mikermak/StereoBoy_Firmware/retroid/artwork/kleur_cartridge_boven_50.98x60.68mm_1200dpi.png

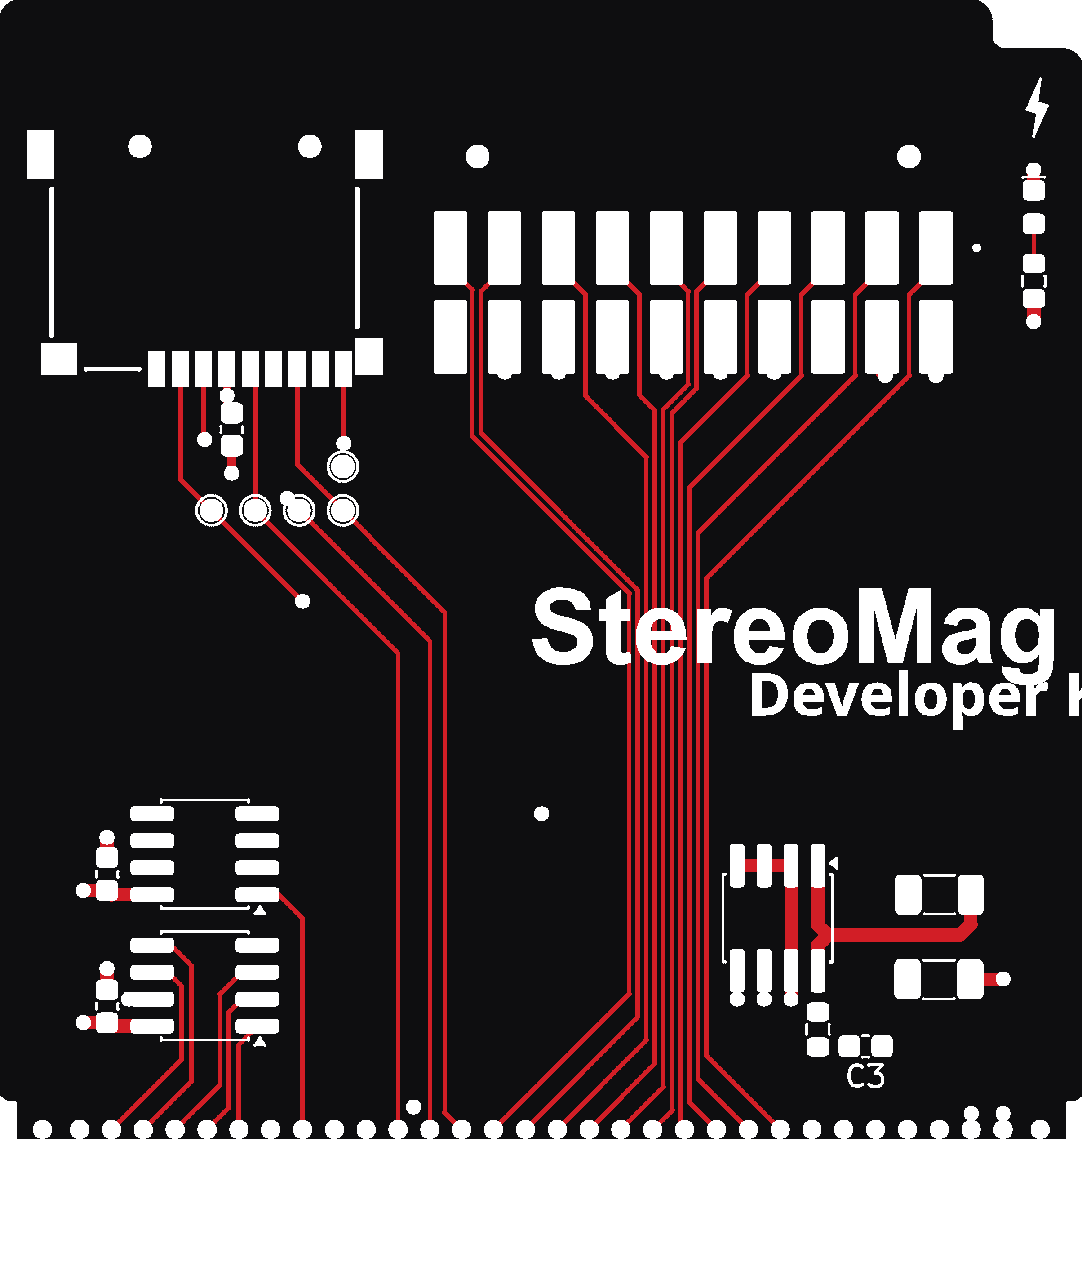
retroid/artwork/kleur_cartridge_boven_50.98x60.68mm_1200dpi.png
