mikermak/StereoBoy_Firmware/retroid/artwork/kleur_hoofdprint_onder_69.67x116.69mm_1200dpi.png

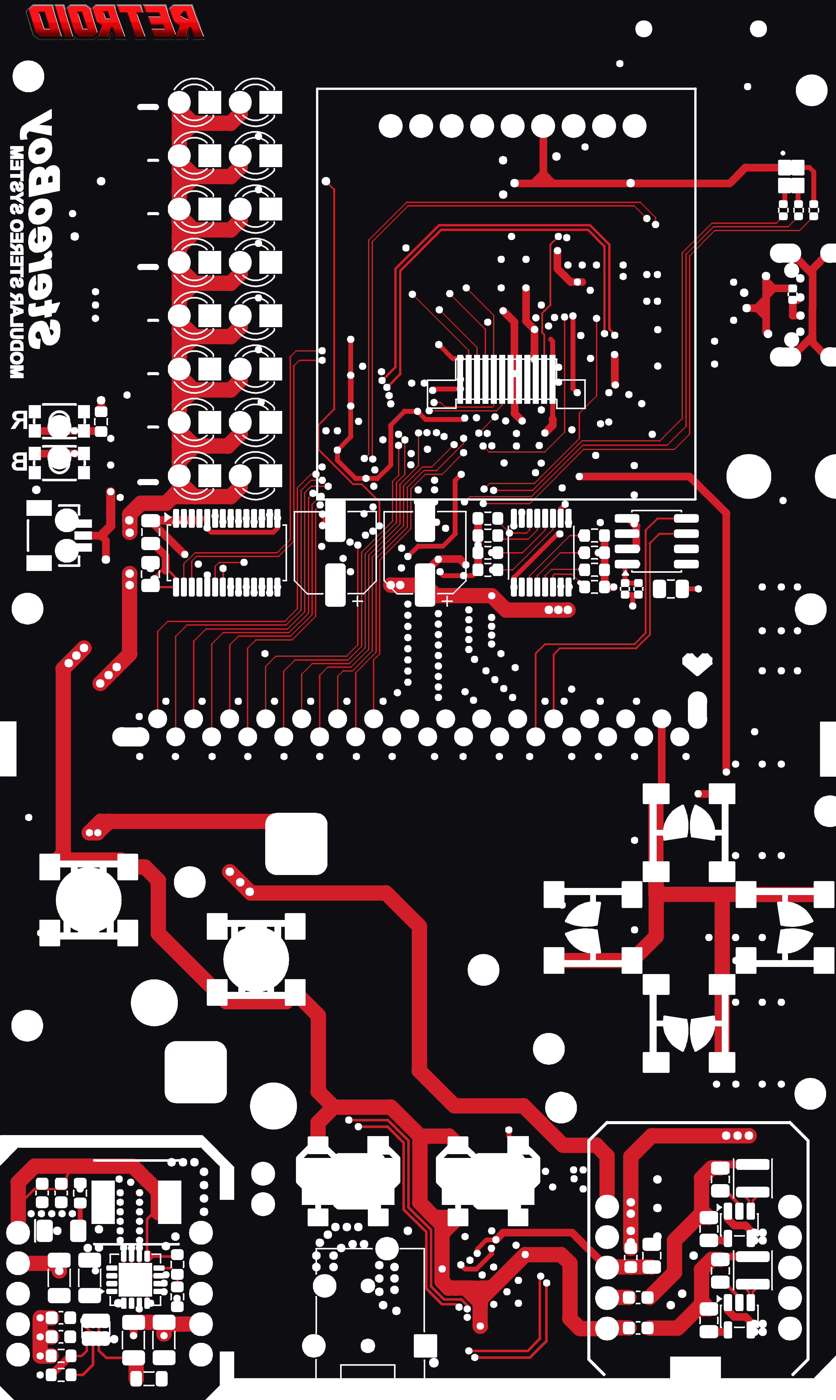
retroid/artwork/kleur_hoofdprint_onder_69.67x116.69mm_1200dpi.png
