mikermak/StereoBoy_Firmware/retroid/artwork/voorbeeld_cartridge_boven.png

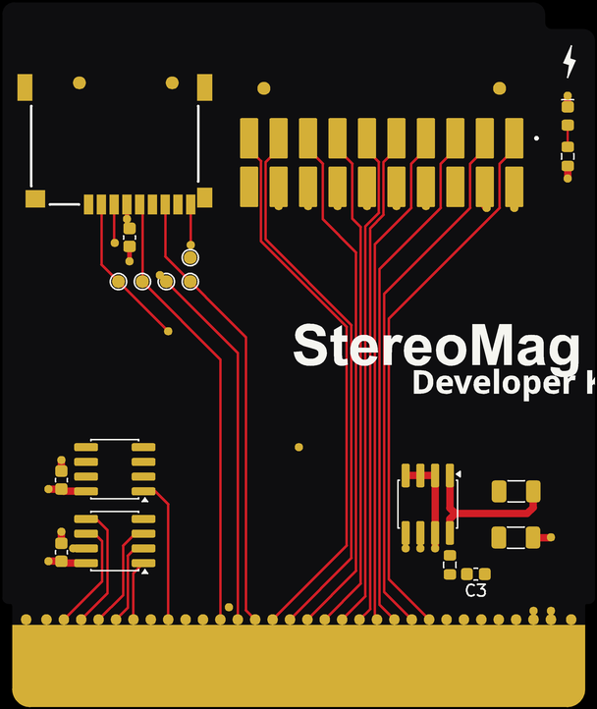
retroid/artwork/voorbeeld_cartridge_boven.png
