mikermak/StereoBoy_Firmware/retroid/productie/cartridge/JLCPCB_BOM.csv

Comment | Designator | Footprint | LCSC Part #
W25Q16JVSNIQ | U1 | SOIC-8_3.9x4.9mm_P1.27mm | C115407
TF-01A microSD push-push | J6 | microSD_External_Pin | C20613191
100nF 1206 | C1,C2 | C_1206_3216Metric | C24497
100nF 0603 | C6,C7,C8 | C_0603_1608Metric
10uF 0603 | C3 | C_0603_1608Metric
470R 0603 | R1 | R_0603_1608Metric | C23179
110k 0603 | R2 | R_0603_1608Metric
Green LED 0603 | D1 | LED_0603_1608Metric_Green
