mikermak/StereoBoy_Firmware/retroid/StereoBoy_bestellijst.xlsx

Sheet: Overzicht
StereoBoy - haalbaarheid en bestelplan
Gebaseerd op github.com/iamericmin/StereoBoy_Firmware (commit a4c152c, 30-9-2026) + StereoMag-cartridge van hackaday.io/project/205771
Onderdeel | Status | Wat betekent dat voor jou
Hoofdprint (KiCad) | Compleet | Schema + printontwerp staan in de repo. De ontwerper meldt dat R1 volledig werkt. 4 lagen, 1,0 mm dik, ca. 70 x 117 mm, onderdelen aan BEIDE kanten. Open het in KiCad 10 (ouder lukt niet).
Gerbers in de repo | Opgelost | De zip in de repo is van 9-3-2026. Nieuwe gerbers, boorbestanden en posities zijn met KiCad 10.0.6 gemaakt: zie productie/.
PSU-module | Op dezelfde print | Linksonder zit een los af te breken voedingsmoduletje (boost, power-mux). R1 = AAA-batterijen. De ontwerper werkt aan R2 met een LiPo - die is nog niet gepubliceerd.
Cartridge (StereoMag) | Apart te downloaden | Staat NIET in de GitHub-repo, wel op Hackaday (stereoMag.kicad_*). Op de cartridge zitten de flashchip (de firmware!) en het microSD-slot. Zonder cartridge start het apparaat niet.
Firmware | Compileert | Door mij getest: bouwt zonder fouten met Pico SDK 2.3.0 (180 KB flash, 205 KB RAM). Past ruim in de 2 MB-flash.
Firmware <-> cartridge | Opgelost (ongetest) | De firmware gebruikte SDIO; de cartridge is via SPI aangesloten. Aangepast in hw_config.c: firmware/StereoBoy_FW_sd-spi.uf2 + patch. Compileert, maar is nog niet op echte hardware getest.
Muziekbibliotheek-script | Ontbreekt | De firmware heeft .artists.sbc / .albums.sbc / .tracks.sbc (+ artwork.lut/bin) op de SD-kaart nodig. Het Python-script dat die maakt staat niet in de repo. Het formaat is gewoon een dump van C-structs, dus na te bouwen.
Behuizing | Game Boy Pocket | Past in een (aftermarket) GB Pocket-behuizing. STL's voor een 3D-geprinte batterij-achterkant + klepje staan in KiCad_files/stereoBoy_3D (te printen op je Bambu A1).
Conclusie |  | Haalbaar, maar geen beginnersbouwpakket. Laat de hoofdprint bij JLCPCB monteren (QFN-80 met 0,4 mm pitch en 0402-onderdelen aan twee kanten). De cartridge (SOIC/0603) en de THT-onderdelen kun je zelf solderen. Reken op 2 software-klusjes: SD-kaart via SPI, en een script voor de bibliotheek.
Aanpak in stappen
1 |  | KLAAR: KiCad 10 geinstalleerd, DRC gedraaid en de productiebestanden staan in de map productie/.
2 |  | Bestel bij JLCPCB: 4 lagen, 1,0 mm, ENIG. Montage aan beide kanten. Upload productie/hoofdprint/gerbers_hoofdprint.zip, JLCPCB_BOM.csv en JLCPCB_CPL.csv. Controleer in de preview de draaiing van elk IC (zie productie/BESTELLEN.md).
3 |  | Onderdelen die JLC niet heeft (VS1053B-L, spoelen L1/L4/L5/L9, RGB-LED, enz.) bestel je bij Digikey/Mouser: laat ze door JLC monteren (eigen onderdelen opsturen of global sourcing) of soldeer ze zelf.
4 |  | Bestel de cartridgeprint (2 lagen, 1,0 mm, ENIG voor de goudcontacten) en soldeer hem zelf - zie tabblad Cartridge.
5 |  | Bestel de losse onderdelen en de behuizing (tabblad Behuizing & los). Print de batterij-achterkant.
6 |  | Firmware: houd SW2 (BOOTSEL) ingedrukt, druk op SW1 (reset), en sleep het .uf2-bestand naar de USB-schijf. De cartridge moet erin zitten (daar zit de flash).
7 |  | Zet MP3's op een FAT32-microSD en genereer de .sbc-cachebestanden (script nog te schrijven).
Kostenschatting (EUR, eerste exemplaar) |  | Printprijs en onderdelen gecheckt op 1-10-2026 (zie tabblad Prijzen). De montage is een schatting.
Hoofdprint 5 st. (4 lagen, 1,0 mm, ENIG, zwart) | ca. 52 | Gecheckt: $55,60.
Verzending JLCPCB (DHL, inclusief invoerkosten) | ca. 29 | Gecheckt: $30,86.
Montage 2 st. aan beide kanten, incl. onderdelen | 140 - 205 | Schatting. VS1053B alleen is al $16,50 per stuk.
Digikey (L1, L4/L5, volumewiel) + verzending | 5 - 25 | Onder EUR 50 betaal je verzendkosten; je kunt JLC ze ook laten inkopen.
Cartridgeprint + onderdelen | 15 - 30 | Kan in dezelfde JLC-bestelling (scheelt verzending).
Behuizing, scherm en losse onderdelen | 30 - 50 | Gecheckt: scherm ca. EUR 3, GBP-shell EUR 11-14.
Totaal (indicatie) | 270 - 390 | Je hebt daarna onderdelen voor een tweede exemplaar.

Sheet: Prijzen
Gecheckte prijzen en voorraad (1-10-2026)
Opgezocht in de browser op jlcpcb.com, lcsc.com, digikey.nl en aliexpress.com. Er is niets besteld.
Wat | Waar / LCSC # | Voorraad | Prijs | Opmerking
PCB hoofdprint, 5 st. | JLCPCB | 4 lagen, 70x117 mm, 1,0 mm, zwart, ENIG, via 0,2 mm | $55,60 | Opbouw: board $5,10 + engineering $25 + ENIG $17,50 + zwart $8. Groen scheelt $8; HASL i.p.v. ENIG scheelt $17,50.
Verzending DHL Express | JLCPCB | DDP (invoerkosten inbegrepen), 2-4 werkdagen | $30,86 | Geschat door JLC op basis van gewicht.
RP2350B | JLCPCB C42415655 | Op voorraad: 3.875 | $1,28 | LCSC zelf: niet leverbaar; via JLC-montage wel.
VS1053B-L | JLCPCB C9922 | Pre-order, ca. 11 dagen | $16,51 | Duurste onderdeel. LCSC: 0 op voorraad.
TLV320DAC3100IRHBR | JLCPCB C179677 | Op voorraad: 2.171 | $1,87
TPS61090RSAR | JLCPCB C206167 | Op voorraad: 2.436 | $2,20
PCA9685PW,118 | JLCPCB C2678753 | Op voorraad: 430 | $2,87 | Alternatief C92206 ($3,64, 1.209 st.).
SN74HC165PWR | LCSC C43420 | Op voorraad: 31.435 | $0,23
APX803S-31SA-7 | LCSC C129757 | Op voorraad: 2.968 | $0,39
AOTA-B201610S3R3-101-T (L9) | LCSC C42411119 | Op voorraad: 3.675 | $0,29
PKMCS0909E4000-R1 (zoemer) | JLCPCB C910763 | Op voorraad: 1.483 | $1,10
BAT60JFILM (D22) | JLCPCB C5377811 | Op voorraad: 4 | $0,06 | Weinig voorraad. Gelijkwaardig: BAT60B C3018529 (47.342 st.).
CLMVC RGB-LED (D17) | JLCPCB C5187905 | Pre-order, min. 56 st., ca. 25 dagen | $8,69 | Overweeg een vervanger met dezelfde footprint (2x2 mm, common anode).
AMELA3012S-2R2MT (L4, L5) | Digikey 535-AMELA3012S-2R2MTCT-ND | Op voorraad: 827 | EUR 0,84 /st. | Niet bij LCSC/JLC.
AMPLH7020S-6R8MT (L1) | Digikey | Op voorraad: 2.001 | EUR 0,73 | Niet bij LCSC/JLC.
RK10J11R0A0L (volumewiel) | Digikey | Op voorraad: 2.984 | EUR 2,44
Scherm 1,54" ST7789 240x240 (kaal paneel) | AliExpress | - | ca. EUR 3,20 | Controleer of het de 12-pins soldeer-FPC is.
Game Boy Pocket-shell incl. knoppen | AliExpress | - | EUR 11 - 14
Niet gecheckt: montagekosten | JLCPCB |  |  | Daarvoor moeten de gerbers en de BOM op jlcpcb.com geupload worden; dat kan de ingebouwde browser niet. Schatting voor 2 st. aan beide kanten incl. onderdelen: $150 - 220.

Sheet: Hoofdprint
Hoofdprint (stereoBoy_MGB) - onderdelenlijst per bord
Uit het printbestand gehaald. Geel = let op. Grijs = optioneel. Aantal borden in E3 aanpassen; kolom F rekent mee.
 |  |  | Aantal borden: | 1
Groep | Designators | Waarde | Footprint | Per bord | Te bestellen | Kant | Onderdeel (MPN-advies) | LCSC # | Montage | Nodig? | Opmerking
IC's | U1 | CODECODER-VS1053B_LQFP48_ | VS1053b | 1 |  | Boven | VS1053B-L | C9922 | SMT (JLCPCB) | Nodig | MP3-decoder. Bij JLC pre-order: ca. $16,50, levertijd ca. 11 dagen. Firmware is geschreven voor VS1053B. De ontwerper bestelde zelf VS1063A-L (C486306); dat is NIET getest met deze firmware. Neem VS1053B-L.
IC's | U2 | PCA9685PW | TSSOP-28_4.4x9.7mm_P0.65mm | 1 |  | Onder | PCA9685PW,118 | C2678753 | SMT (JLCPCB) | Nodig | LED-driver voor de 16 VU-LEDs.
IC's | U3 | TPS61090 | Texas_RSA_VQFN-16-1EP_4x4mm_P0.65mm_EP2.7x2.7mm_ThermalVias | 1 |  | Onder | TPS61090RSAR | C206167 | SMT (JLCPCB) | Nodig | LET OP: 5V-boost met spanningsdeler (R4/R13) = de verstelbare TPS61090. De ontwerper kocht TPS61092 (vaste 5V) - die NIET nemen.
IC's | U4, U8 | TLV62569DBV | SOT-23-5 | 2 |  | Onder | TLV62569DBVR | C141836 | SMT (JLCPCB) | Nodig | Buck 3,3V en 1,8V.
IC's | U5 | APX803 | SOT-23 | 1 |  | Boven | APX803S-31SA-7 | C129757 | SMT (JLCPCB) | Nodig | Reset voor het scherm op 3,3V. Niet de APX803L-35 uit de LCSC-lijst van de ontwerper (drempel 3,5V > 3,3V).
IC's | U6 | 74HC165 | TSSOP-16_4.4x5mm_P0.65mm | 1 |  | Onder | SN74HC165PWR | C43420 | SMT (JLCPCB) | Nodig | LET OP: footprint is TSSOP-16 (PW). De ontwerper bestelde SN74HC165DBR (SSOP, breder) - past niet.
IC's | U7 | TPS2116DRL | SOT-583-8 | 1 |  | Onder | TPS2116DRLR | C3235557 | SMT (JLCPCB) | Nodig | Power-mux USB/batterij (zit op de PSU-module).
IC's | U10 | TLV320AIC3100 | VQFN-32-1EP_5x5mm_P0.5mm_EP3.5x3.5mm | 1 |  | Boven | TLV320DAC3100IRHBR | C179677 | SMT (JLCPCB) | Nodig | Op de print staat 'TLV320AIC3100', maar de ontwerper gebruikt de DAC3100 (zelfde behuizing).
IC's | U11 | RP2350B | QFN-80-1EP_10x10mm_P0.4mm_EP3.4x3.4mm | 1 |  | Boven | RP2350B | C42415655 | SMT (JLCPCB) | Nodig | Microcontroller (QFN-80, 0.4 mm pitch). Niet met de hand te doen zonder hete lucht.
IC's | U12 | USBLC6-2P6 | SOT-666 | 1 |  | Boven | USBLC6-2P6 | C15999 | SMT (JLCPCB) | Nodig | ESD-bescherming USB.
IC's | U14 | FM24C64C | SOIC-8_3.9x4.9mm_P1.27mm | 1 |  | Onder | FM24CL64B-GTR | C9829 | SMT (JLCPCB) | Nodig | FRAM op 3,3V. Niet FM24C64B (dat is een 5V-type).
Transistors/diodes/LEDs | D1, D2, D3, D4, D5, D6, D7, D8, D9, D10, D11, D12, D13, D14, D15, D16 | LED | LED_D3.0mm | 16 |  | Onder | 3 mm LED (THT) |  | Zelf solderen (THT) | Nodig | 16 VU-LEDs, zelf solderen. Kleur naar keuze (3D-modellen van de ontwerper: groen/geel).
Transistors/diodes/LEDs | D17 | CLMVC-FKA-CL1D1L71BB7C3C3 | CREE_LED_2mm_x_2mm_Common_Anode | 1 |  | Onder | CLMVC-FKA-CL1D1L71BB7C3C3 | C5187905 | SMT (JLCPCB) | Nodig | RGB-LED 2x2 mm (Cree), common anode. Bij JLC alleen pre-order (min. 56 st., ca. 25 dagen).
Transistors/diodes/LEDs | D22 | BAT60JFILM | SOD-323 | 1 |  | Boven | BAT60JFILM | C5377811 | SMT (JLCPCB) | Nodig | Schottky-diode SOD-323.
Transistors/diodes/LEDs | D23 | Green | LED_1206_3216Metric_Green | 1 |  | Onder | Groene LED 1206 | C7280951 | SMT (JLCPCB) | Nodig
Transistors/diodes/LEDs | Q1 | DMG2301L | SOT-23 | 1 |  | Boven | DMG2301L-7 | C102619 | SMT (JLCPCB) | Nodig
Transistors/diodes/LEDs | Q2 | FDN306P | SOT-23 | 1 |  | Boven | FDN306P | C154510 | SMT (JLCPCB) | Nodig
Transistors/diodes/LEDs | Q3 | BSS138 | SOT-23 | 1 |  | Boven | BSS138LT1G | C82045 | SMT (JLCPCB) | Nodig
Spoelen/kristallen | L1 | 6.8uH | Inductor_7.3x6.6mm | 1 |  | Onder | Abracon AMPLH7020S-6R8MT |  | Zelf solderen (THT) | Nodig | 6,8 uH boost-spoel, 7x7 mm. Digikey 535-AMPLH7020S-6R8MTCT-ND.
Spoelen/kristallen | L2, L6, L8 | 600Ω @ 100MHz | C_0603_1608Metric | 3 |  | Boven/Onder | TDK MPZ1608S601ATA00 | C107335 | SMT (JLCPCB) | Nodig | Ferriet 600 ohm 0603.
Spoelen/kristallen | L3, L7 | 600Ω @ 100MHz | L_0603_1608Metric | 2 |  | Boven/Onder | TDK MPZ1608S601ATA00 | C107335 | SMT (JLCPCB) | Nodig | Ferriet 600 ohm 0603.
Spoelen/kristallen | L4, L5 | 2.2uH | L_APV_ANR3012 | 2 |  | Onder | Abracon AMELA3012S-2R2MT |  | SMT (JLCPCB) | Nodig | Footprint is 3x3 mm; het MPN-veld (XAL4020, 4x4 mm) klopt niet. Digikey 535-AMELA3012S-2R2MTCT-ND.
Spoelen/kristallen | L9 | 3.3uH | L_Cenker_CKCS201610 | 1 |  | Boven | AOTA-B201610S3R3-101-T | C42411119 | SMT (JLCPCB) | Nodig | 3,3 uH voor de core-regelaar van de RP2350 (standaard Raspberry Pi-keuze).
Spoelen/kristallen | L10 | 600Ω @ 100MHz | L_0805_2012Metric | 1 |  | Onder | Ferriet 600 ohm @100 MHz 0805, >=1 A |  | SMT (JLCPCB) | Nodig
Spoelen/kristallen | Y1, Y2 | 12MHz | Crystal_SMD_3225-4Pin_3.2x2.5mm | 2 |  | Boven | ABM8-272-T3 (12 MHz) | C20625731 | SMT (JLCPCB) | Nodig
Connectors/knoppen | BTN_A1, BTN_B1 | GameBoy_ButtonPad | GameBoy_A_B_Pad | 2 |  | Onder | Geen onderdeel: GB-membraan |  | SMT (JLCPCB) | Optioneel | De footprint heeft het originele Game Boy-contactpatroon. Een siliconen membraan uit een (donor-)GBP werkt dus. De 4 buitenste pads zijn een optie voor een tactiele schakelaar.
Connectors/knoppen | BTN_D1, BTN_L1, BTN_R1, BTN_U1 | GameBoy_ButtonPad | GameBoy_DPad | 4 |  | Onder | Geen onderdeel: GB-membraan |  | SMT (JLCPCB) | Optioneel | D-pad met het originele GB-contactpatroon. Werkt met het D-pad-membraan.
Connectors/knoppen | BZ1 | Buzzer | Buzzer_CUI_CPT-9019S-SMT | 1 |  | Boven | PKMCS0909E4000-R1 | C910763 | SMT (JLCPCB) | Nodig | Footprint heet 'CUI CPT-9019S', 3D-model is Murata. Beide 9x9 mm: leg de pads naast de datasheet.
Connectors/knoppen | J2 | JST_1mm_3_Vertical | JST_1x03_P1.0mm_Horizontal_SMD | 1 |  | Onder | JST SM03B-SRSS-TB | C160403 | SMT (JLCPCB) | Optioneel | Optioneel: SWD-debugpoort.
Connectors/knoppen | J4, J8 | Conn_01x02 | 1x02_P2.54mm | 2 |  | Boven | Pinheader 1x02 2,54 mm |  | Zelf solderen (THT) | Optioneel | Optioneel (reset/boot-jumper).
Connectors/knoppen | J5 | SJ-43514 | SJ_43514 | 1 |  | Onder | CUI SJ-43514 | C20182909 | Zelf solderen (THT) | Nodig | 3,5 mm koptelefoonaansluiting, THT.
Connectors/knoppen | J6 | Conn_01x09 | 1x09_P2.54mm | 1 |  | Boven | Pinheader 1x09 2,54 mm |  | Zelf solderen (THT) | Optioneel | NIET nodig als je het kale FPC-scherm op J1 gebruikt (alternatief voor een schermmodule).
Connectors/knoppen | J7 | USB_C_Receptacle_USB2.0_16P | USB_C_Receptacle_GCT_USB4105-xx-A_16P_TopMnt_Horizontal | 1 |  | Boven | GCT USB4105-GF-A-120 | C5184243 | SMT (JLCPCB) | Nodig | USB-C.
Connectors/knoppen | J10, J11 | Conn_01x05 | 1x05_P2.54mm | 2 |  | Boven | Pinheader 1x05 2,54 mm |  | Zelf solderen (THT) | Nodig | Verbinding PSU-module <-> hoofdprint. Controleer hoe de module erop gaat.
Connectors/knoppen | J13 | Conn_01x10 | StereoBoy_PSU | 1 |  | Onder | (pads, geen onderdeel) |  | SMT (JLCPCB) | Nodig | Landingsplek van de PSU-module.
Connectors/knoppen | SELECT1, START1 | SMD_6x3.5mm_h2.5mm | GameBoy_Select_Start | 2 |  | Onder | Geen onderdeel: GB-membraan |  | SMT (JLCPCB) | Optioneel | Select/Start-contactpads voor het originele membraan.
Connectors/knoppen | SW1, SW2 | SMD_4.6x2.8mm_h2.5mm | Push_SMD_4.6x2.8mm_h2.5mm | 2 |  | Onder | C&K KMR221GLFS | C72443 | SMT (JLCPCB) | Nodig | SW1 = reset, SW2 = BOOTSEL. Past op de SparkFun-footprint 4,6 x 2,8 mm (3D-model h=1,9 mm). Door JLC te plaatsen.
Connectors/knoppen | VR1 | RK10J11R0A0L | RK10J11R0A0L | 1 |  | Boven | Alps RK10J11R0A0L |  | Zelf solderen (THT) | Nodig | Duimwiel-volumeknop. Mouser 688-RK10J11R0A0L. LCSC had alleen de ...A0H (C470766).
Condensatoren | C1 | 100uF | CP_EIA-7343-15_Kemet-W_HandSolder | 1 |  | Boven | Tantaal 100 uF >=10 V, EIA 7343-15 (W-case) |  | SMT (JLCPCB) | Nodig | Lage behuizing (1,5 mm) nodig. De ontwerper kocht TAJD337 (D-case, 3,1 mm hoog) - past niet op deze footprint.
Condensatoren | C2 | 47uF | CP_EIA-7343-15_Kemet-W_HandSolder | 1 |  | Boven | Tantaal 47 uF >=10 V, EIA 7343-15 (W-case) |  | SMT (JLCPCB) | Nodig | Lage behuizing (1,5 mm).
Condensatoren | C3, C4 | 10pF | C_0402_1005Metric | 2 |  | Boven | 10 pF 0402 C0G | C161520 | SMT (JLCPCB) | Nodig
Condensatoren | C5, C6, C15, C16, C17, C18, C19, C22, C23, C25, C26, C37, C47, C49, C52, C57, C58, C60, C75, C79 | 0.1uF | C_0402_1005Metric | 20 |  | Boven/Onder | Condensator 0.1uF 0402 |  | SMT (JLCPCB) | Nodig
Condensatoren | C7, C54, C85 | 0.1uF | C_0603_1608Metric | 3 |  | Boven/Onder | Condensator 0.1uF 0603 |  | SMT (JLCPCB) | Nodig
Condensatoren | C8 | 10uF | C_1206_3216Metric | 1 |  | Onder | Condensator 10uF 1206 |  | SMT (JLCPCB) | Nodig
Condensatoren | C9, C11 | 4.7uF | C_0805_2012Metric | 2 |  | Boven | 4,7 uF 0805 | C98192 | SMT (JLCPCB) | Nodig
Condensatoren | C10, C12 | 6.8pF | C_0805_2012Metric | 2 |  | Onder | 6,8 pF 0805 NP0 | C519995 | SMT (JLCPCB) | Nodig
Condensatoren | C13, C24, C27, C31, C36, C38, C39, C40, C41, C71 | 1.0uF | C_0402_1005Metric | 10 |  | Boven | Condensator 1.0uF 0402 |  | SMT (JLCPCB) | Nodig
Condensatoren | C14 | 4.7uF | C_0402_1005Metric | 1 |  | Boven | Condensator 4.7uF 0402 |  | SMT (JLCPCB) | Nodig
Condensatoren | C20, C21 | 15pF | C_0402_1005Metric | 2 |  | Boven | 15 pF 0402 C0G | C440152 | SMT (JLCPCB) | Nodig
Condensatoren | C28 | 100uF | C_0603_1608Metric | 1 |  | Boven | 100 uF 0603 |  | SMT (JLCPCB) | Nodig | 100 uF in 0603 is zeldzaam/duur. Check de stock of neem in overleg 47 uF 0603.
Condensatoren | C29, C61, C64, C68, C69, C76, C87 | 1.0uF | C_0805_2012Metric | 7 |  | Boven/Onder | Condensator 1.0uF 0805 |  | SMT (JLCPCB) | Nodig
Condensatoren | C30, C86 | 10uF | C_0805_2012Metric | 2 |  | Onder | Condensator 10uF 0805 |  | SMT (JLCPCB) | Nodig
Condensatoren | C32, C33, C48, C53, C62, C77, C78, C80 | 100uF | C_1206_3216Metric | 8 |  | Boven/Onder | 100 uF 1206, 6,3 V X5R | C15008 | SMT (JLCPCB) | Nodig
Condensatoren | C34, C42, C45, C46, C51, C55, C56, C66, C67, C70, C72, C73, C74, C88 | 1.0uF | C_1206_3216Metric | 14 |  | Boven/Onder | Condensator 1.0uF 1206 |  | SMT (JLCPCB) | Nodig
Condensatoren | C43, C44 | 10uF | CP_Elec_6.3x4.5 | 2 |  | Onder | Elco 10 uF >=10 V, SMD 6,3 x 4,5 mm |  | SMT (JLCPCB) | Nodig
Condensatoren | C59 | 0.1uF | C_0805_2012Metric | 1 |  | Onder | Condensator 0.1uF 0805 |  | SMT (JLCPCB) | Nodig
Condensatoren | C63 | 2.2uF | C_0603_1608Metric | 1 |  | Onder | Condensator 2.2uF 0603 |  | SMT (JLCPCB) | Nodig
Condensatoren | C65 | 10uF | C_0603_1608Metric | 1 |  | Onder | Condensator 10uF 0603 |  | SMT (JLCPCB) | Nodig
Condensatoren | C81 | 0.1uF | WAi_0402_1005Metric | 1 |  | Boven | Condensator 0.1uF 0402 |  | SMT (JLCPCB) | Nodig
Condensatoren | C82 | 4.7uF | WAi_0402_1005Metric | 1 |  | Boven | Condensator 4.7uF 0402 |  | SMT (JLCPCB) | Nodig
Condensatoren | C83, C84 | 22.1uF | C_0402_1005Metric | 2 |  | Boven | 22 uF 0402, 6,3 V X5R |  | SMT (JLCPCB) | Nodig | Op de print staat '22.1uF' - bedoeld is 22 uF.
Weerstanden | R1 | 500k | R_0603_1608Metric | 1 |  | Onder | Weerstand 500k 0603 |  | SMT (JLCPCB) | Nodig
Weerstanden | R2 | 330 | R_0603_1608Metric | 1 |  | Boven | Weerstand 330 0603 |  | SMT (JLCPCB) | Nodig
Weerstanden | R3 | 390k | R_0603_1608Metric | 1 |  | Onder | Weerstand 390k 0603 |  | SMT (JLCPCB) | Nodig
Weerstanden | R4 | 1.62M | C_0402_1005Metric | 1 |  | Boven | 1,62 Mohm 0402 |  | SMT (JLCPCB) | Nodig | Staat op een condensator-footprint (0402) - gewoon een 0402-weerstand. Bepaalt de 5V (samen met R13).
Weerstanden | R5, R6, R7, R8, R9, R10, R11, R12, R20, R24, R27, R29, R34, R39 | 10k | R_0603_1608Metric | 14 |  | Boven/Onder | Weerstand 10k 0603 |  | SMT (JLCPCB) | Nodig
Weerstanden | R13 | 180k | C_0402_1005Metric | 1 |  | Boven | Weerstand 180k 0402 |  | SMT (JLCPCB) | Nodig
Weerstanden | R14, R15 | 27 | C_0402_1005Metric | 2 |  | Boven | 27 ohm 0402 | C138021 | SMT (JLCPCB) | Nodig
Weerstanden | R16, R33 | 5.1k | R_0603_1608Metric | 2 |  | Boven | Weerstand 5.1k 0603 |  | SMT (JLCPCB) | Nodig
Weerstanden | R17, R18, R19 | 330 | R_0402_1005Metric | 3 |  | Onder | Weerstand 330 0402 |  | SMT (JLCPCB) | Nodig
Weerstanden | R21, R22, R23 | 0 | R_0603_1608Metric | 3 |  | Boven | Weerstand 0 0603 |  | SMT (JLCPCB) | Nodig
Weerstanden | R25 | 33 | R_0402_1005Metric | 1 |  | Boven | 33 ohm 0402 | C137880 | SMT (JLCPCB) | Nodig
Weerstanden | R26, R49 | 1k | R_0402_1005Metric | 2 |  | Boven | Weerstand 1k 0402 |  | SMT (JLCPCB) | Nodig
Weerstanden | R28 | 10 | R_0603_1608Metric | 1 |  | Boven | Weerstand 10 0603 |  | SMT (JLCPCB) | Nodig
Weerstanden | R30, R54 | 10K | R_0402_1005Metric | 2 |  | Boven | Weerstand 10K 0402 |  | SMT (JLCPCB) | Nodig
Weerstanden | R31 | 1k | R_0603_1608Metric | 1 |  | Boven | Weerstand 1k 0603 |  | SMT (JLCPCB) | Nodig
Weerstanden | R32, R58, R59, R60, R61, R62, R63, R64, R65, R66, R67, R68, R69, R70, R71, R72 | 220 | R_0402_1005Metric | 16 |  | Boven | Weerstand 220 0402 |  | SMT (JLCPCB) | Nodig
Weerstanden | R35 | 453k | R_0603_1608Metric | 1 |  | Boven | 453 kohm 0603 | C273765 | SMT (JLCPCB) | Nodig
Weerstanden | R36, R38 | 100k | R_0603_1608Metric | 2 |  | Boven | 100 kohm 0603 | C14675 | SMT (JLCPCB) | Nodig
Weerstanden | R37 | 200k | R_0603_1608Metric | 1 |  | Boven | 200 kohm 0603 | C105574 | SMT (JLCPCB) | Nodig
Weerstanden | R44 | 100k | R_0805_2012Metric | 1 |  | Boven | Weerstand 100k 0805 |  | SMT (JLCPCB) | Nodig
Weerstanden | R45, R46, R47, R48 | 2.2K | R_0402_1005Metric | 4 |  | Boven | Weerstand 2.2K 0402 |  | SMT (JLCPCB) | Nodig
Weerstanden | R50 | 100K | R_0402_1005Metric | 1 |  | Boven | Weerstand 100K 0402 |  | SMT (JLCPCB) | Nodig
Weerstanden | R51 | 1M | R_0402_1005Metric | 1 |  | Boven | 1 Mohm 0402 | C138033 | SMT (JLCPCB) | Nodig
Weerstanden | R53 | 2.2k | R_0402_1005Metric | 1 |  | Boven | Weerstand 2.2k 0402 |  | SMT (JLCPCB) | Nodig
Weerstanden | R55, R56 | 1.4M | R_0603_1608Metric | 2 |  | Onder | Weerstand 1.4M 0603 |  | SMT (JLCPCB) | Nodig
Weerstanden | R73 | 220 | R_0603_1608Metric | 1 |  | Onder | Weerstand 220 0603 |  | SMT (JLCPCB) | Nodig
 |  |  | Totaal plaatsingen
LCSC-nummers komen uit de eigen LCSC-bestellijst van de ontwerper (KiCad_files/BOM) en zijn gecheckt op behuizing. Lege LCSC-cel = laat de JLCPCB-BOM-tool zoeken op waarde + behuizing.

Sheet: Cartridge
Cartridge 'StereoMag dev kit' - onderdelenlijst
Bron: hackaday.io/project/205771/files (stereoMag.kicad_pcb, 24-5-2026). 2 lagen, 1,0 mm. Alles SOIC/0603/1206, zelf te solderen.
Designator | Waarde / behuizing | Aantal | Onderdeel (MPN-advies) | LCSC # | Nodig? | Opmerking
PCB | - | 1 | 2 lagen, 1,0 mm, ENIG (goud voor de randcontacten), afgeschuinde rand optioneel |  | Nodig | Bestellen bij JLCPCB/PCBWay; gerbers zelf exporteren uit stereoMag.kicad_pcb (KiCad 9/10).
U1 | Flash SOIC-8 (150 mil) | 1 | Winbond W25Q16JVSNIQ (2 MB) | C115407 | Nodig | Hier staat de firmware op. Zonder cartridge start het apparaat niet.
J6 | microSD push-push | 1 | microSD-slot (footprint SparkFun 'microSD_External_Pin') | C20613191 | Nodig | LET OP: de ontwerper kocht XYECONN TF-01A (C20613191) en CUI MSD-4-A. Leg de footprint naast de datasheet voor je bestelt. Bedraad als SPI - zie tabblad Let op.
C1, C2 | 0.1uF 1206 | 2 | CL31B104KBCNNNC | C24497 | Nodig
C6, C7, C8 | 0.1uF 0603 | 3 | 0603 X7R 100 nF |  | Nodig
C3 | 10uF 0603 | 1 | 0603 X5R 10 uF |  | Nodig
R1 | 470 ohm 0603 | 1 | 0603 470 ohm |  | Nodig | Voor de LED.
R2 | 110k 0603 | 1 | 0603 110 kohm |  | Nodig | In het schema 10k, op de print 110k: neem de waarde van de print.
D1 | Groene LED 0603 | 1 | 0603 groen |  | Nodig
U4 | PSRAM SOIC-8 | 1 | APMemory APS1604M-3SQR |  | Optioneel | De firmware gebruikt geen PSRAM (0 bytes).
U2 | FRAM SOIC-8 | 1 | FM24CL64B-GTR | C9829 | Optioneel | Er zit al FRAM op de hoofdprint.
J2 | Header 2x10 SMD | 1 | Samtec TSM-110-01-S-DH-LC |  | Optioneel | Uitbreidingsheader voor ontwikkelaars.
- | Cartridge-behuizing | 1 | Game Boy (DMG) cartridge-shell + gamebit-schroevendraaier |  | Nodig | AliExpress, ca. 2 euro.

Sheet: Behuizing & los
Behuizing, scherm en losse onderdelen
Vooral AliExpress / Game Boy-onderdelenwinkels (bv. Retro Modding, Kitsch-Bent, Hand Held Legend). Prijzen zijn een indicatie.
Wat | Plek op print | Aantal | Omschrijving | Indicatie EUR | Opmerking
Scherm | J1 | 1 | 1,54" IPS 240x240 ST7789, 12-pins soldeer-FPC (kaal paneel, géén module) | 3 - 5 | Pinout op de print: 1 GND, 2 LEDK, 3 LEDA(3V3), 4 VDD(3V3), 5 GND, 6 GND, 7 DC, 8 CS, 9 SCL, 10 SDA, 11 RES, 12 GND. Vergelijk dit met de listing.
DONOR-GBP (aanrader) | - | 1 | Kapotte/goedkope Game Boy Pocket: daaruit haal je cartridge-slot, aan/uit-schakelaar, speaker, batterijcontacten, membranen en knoppen | 15 - 30 | Vervangt de regels Cartridge-slot, Aan/uit-schakelaar, Speaker, Batterijcontacten en de membranen hieronder. De shell kun je ook hergebruiken, maar een nieuwe aftermarket-shell oogt mooier.
Behuizing | - | 1 | Game Boy Pocket-shell (aftermarket) incl. knoppen en siliconen membranen | 8 - 15 | Niet nodig als je de donor-shell hergebruikt. Bestandsnaam 'MGB' = Game Boy Pocket.
Batterij-achterkant | - | 1 | 3D-print: 'AA Battery Pocket Rear V7.stl' + 'AA Battery Cover V4.stl' | - | In KiCad_files/stereoBoy_3D. Ook een aangepaste voorkant: 'OEM CURVE FRONT Revised.stl'.
Schermlens | - | 1 | Lens voor GB Pocket - of zelf maken | 2 - 5 | Het scherm is een vierkant van 1,54"; een standaard GBP-lens heeft een ander venster. Een eigen lens (laser/acryl) is waarschijnlijk nodig.
Cartridge-slot | J3 | 1 | GB Pocket cartridge-connector 32-pins (THT) | 1 - 3 | Zelf solderen.
Aan/uit-schakelaar | SW3 | 1 | GB Pocket power switch (MGB) | 1 - 2
Speaker | SPK_CONN1 | 1 | GB Pocket speaker 8 ohm | 1 - 3 | Met 2 draadjes aan SPK_CONN1. Gestuurd door de class-D van de TLV320.
Batterijcontacten | +0 / -0 | 1 | GB Pocket batterijcontacten (+ en -) | 1 - 2 | Footprints 'MGB+BATTERY4' / 'MGB-BATTERY4'.
Batterijen | - | 3 | AAA-cellen (alkaline ca. 5 u, NiMH ca. 2,5 u) | - | R1 volgens Hackaday: 3x AAA. Er zit geen lader op R1, dus laad NiMH extern op.
VU-LEDs | D1-D16 | 16 | 3 mm LED, kleur naar keuze | 1 | Staat ook op het tabblad Hoofdprint (THT).
Pinheaders | J10, J11 | 2 | 1x05 male 2,54 mm | <1 | Voor de PSU-module.
microSD-kaart | - | 1 | microSD, FAT32 (bv. 32 GB) | 5 - 8 | Voor de muziek + cachebestanden.
Gereedschap | - | 1 | Tri-wing + gamebit-schroevendraaier, flux, fijne soldeerpunt | 5 - 10 | Hete lucht/hotplate alleen nodig als je SMD zelf doet.
Optioneel: debugger | J2/J8 | 1 | Raspberry Pi Debug Probe (SWD) | 12 | Niet nodig: flashen gaat via USB-C (BOOTSEL).

Sheet: Let op
Fouten en tegenstrijdigheden in de bronbestanden
Gevonden door het printbestand, het schema, de BOM-bestanden van de ontwerper en de firmware naast elkaar te leggen.
Prioriteit | Onderwerp | Wat is er aan de hand | Advies
Hoog | SD-kaart: firmware vs cartridge | src/hw_config.c gebruikt SDIO (CLK=GPIO12, CMD=13, D0-D3=14-17). De gepubliceerde StereoMag-cartridge sluit de SD-kaart aan op SPI1 (SCK 30, MOSI 31, MISO 28, CS = GPIO2, detect = GPIO41). | hw_config.c omzetten naar SPI-modus (de FatFS-library kan dat), of een cartridge met SDIO op de HSTX-pinnen ontwerpen.
Hoog | Flash zit op de cartridge | De RP2350B heeft geen eigen flash; QSPI loopt via de cartridgeconnector. | Zonder cartridge met flash: geen boot. Flash de firmware met de cartridge erin.
Hoog | U3 boost-converter | Op de print staat TPS61090 met spanningsdeler R4/R13 (verstelbaar). De LCSC-lijst van de ontwerper heeft TPS61092 (vaste 5V). | Bestel TPS61090RSAR.
Hoog | Script voor de bibliotheek ontbreekt | De README noemt een Python-script voor de .sbc-cache, maar dat staat niet in de repo. | Zelf (laten) schrijven op basis van de structs in lib/sb_util.
Midden | Gerbers verouderd | De gerber-zip is van 9-3-2026; het printbestand heeft back-ups tot 20-4-2026. | Exporteer de gerbers opnieuw uit KiCad 10.
Midden | U6 shift register | Footprint TSSOP-16 (4,4 mm). De ontwerper bestelde SN74HC165DBR (SSOP, 5,3 mm). | Bestel SN74HC165PWR.
Midden | U14 FRAM | Op de print staat FM24C64C; FM24C64B (Digikey-lijst) is een 5V-type. | Bestel FM24CL64B-GTR (3,3 V).
Midden | U5 reset voor het scherm | LCSC-lijst: APX803L-35 (drempel 3,5 V op een 3,3V-lijn = het scherm blijft in reset). | Bestel APX803S-31SA-7 (Digikey-lijst).
Midden | U1 decoder | Hackaday noemt de VS1063, de LCSC-lijst ook. Print en firmware gaan uit van de VS1053B. | Bestel VS1053B-L.
Laag | L4/L5 | Footprint 3x3 mm (ANR3012), maar het MPN-veld zegt XAL4020 (4x4 mm). | AMELA3012S-2R2MT (3x3).
Laag | C1/C2 tantaal | Footprint W-case (laag, 7343-15). De ontwerper kocht een D-case (3,1 mm hoog). | Neem een W-case of een andere lage behuizing, i.v.m. de ruimte in de shell.
Laag | BZ1 zoemer | Footprint CUI CPT-9019S, 3D-model Murata PKMCS0909E. | Controleer of de pads overeenkomen.
Opgelost | Knoppen | A/B, D-pad en Select/Start hebben het originele GB-contactpatroon. | Gewoon GBP-membranen gebruiken. SW1/SW2 (reset/BOOTSEL) = KMR221GLFS, wordt door JLC geplaatst.
Info | KiCad-versie | Het printbestand is KiCad 10-formaat (generator 10.0). | Installeer KiCad 10.
