mikermak/StereoBoy_Firmware/retroid/artwork/omtrek_cartridge.dxf

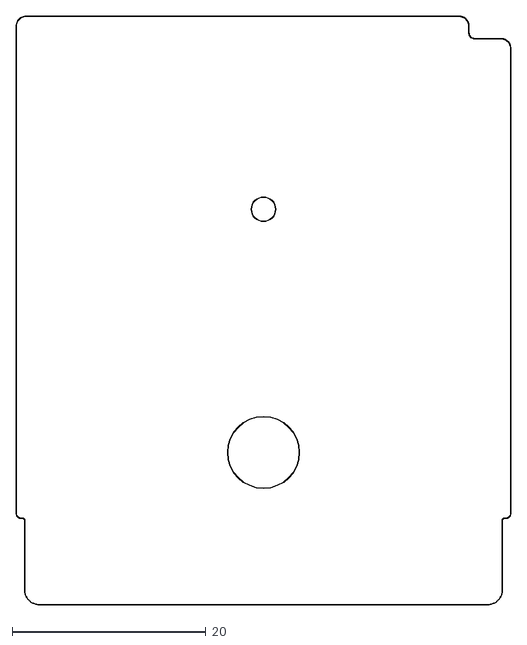
[picture p7: CAD file, 2026-10-01]
retroid/artwork/omtrek_cartridge.dxf
51.0 x 60.7
