mikermak/StereoBoy_Firmware/retroid/artwork/omtrek_hoofdprint.dxf

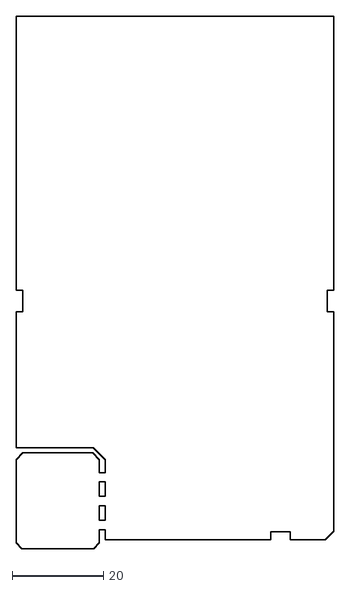
[picture p8: CAD file, 2026-10-01]
retroid/artwork/omtrek_hoofdprint.dxf
69.7 x 116.7
