mikermak/StereoBoy_Firmware/retroid/kicad/cartridge/stereoMag.kicad_pcb

## KiCad design retroid/kicad/cartridge/stereoMag.kicad_pcb (2026-10-01)

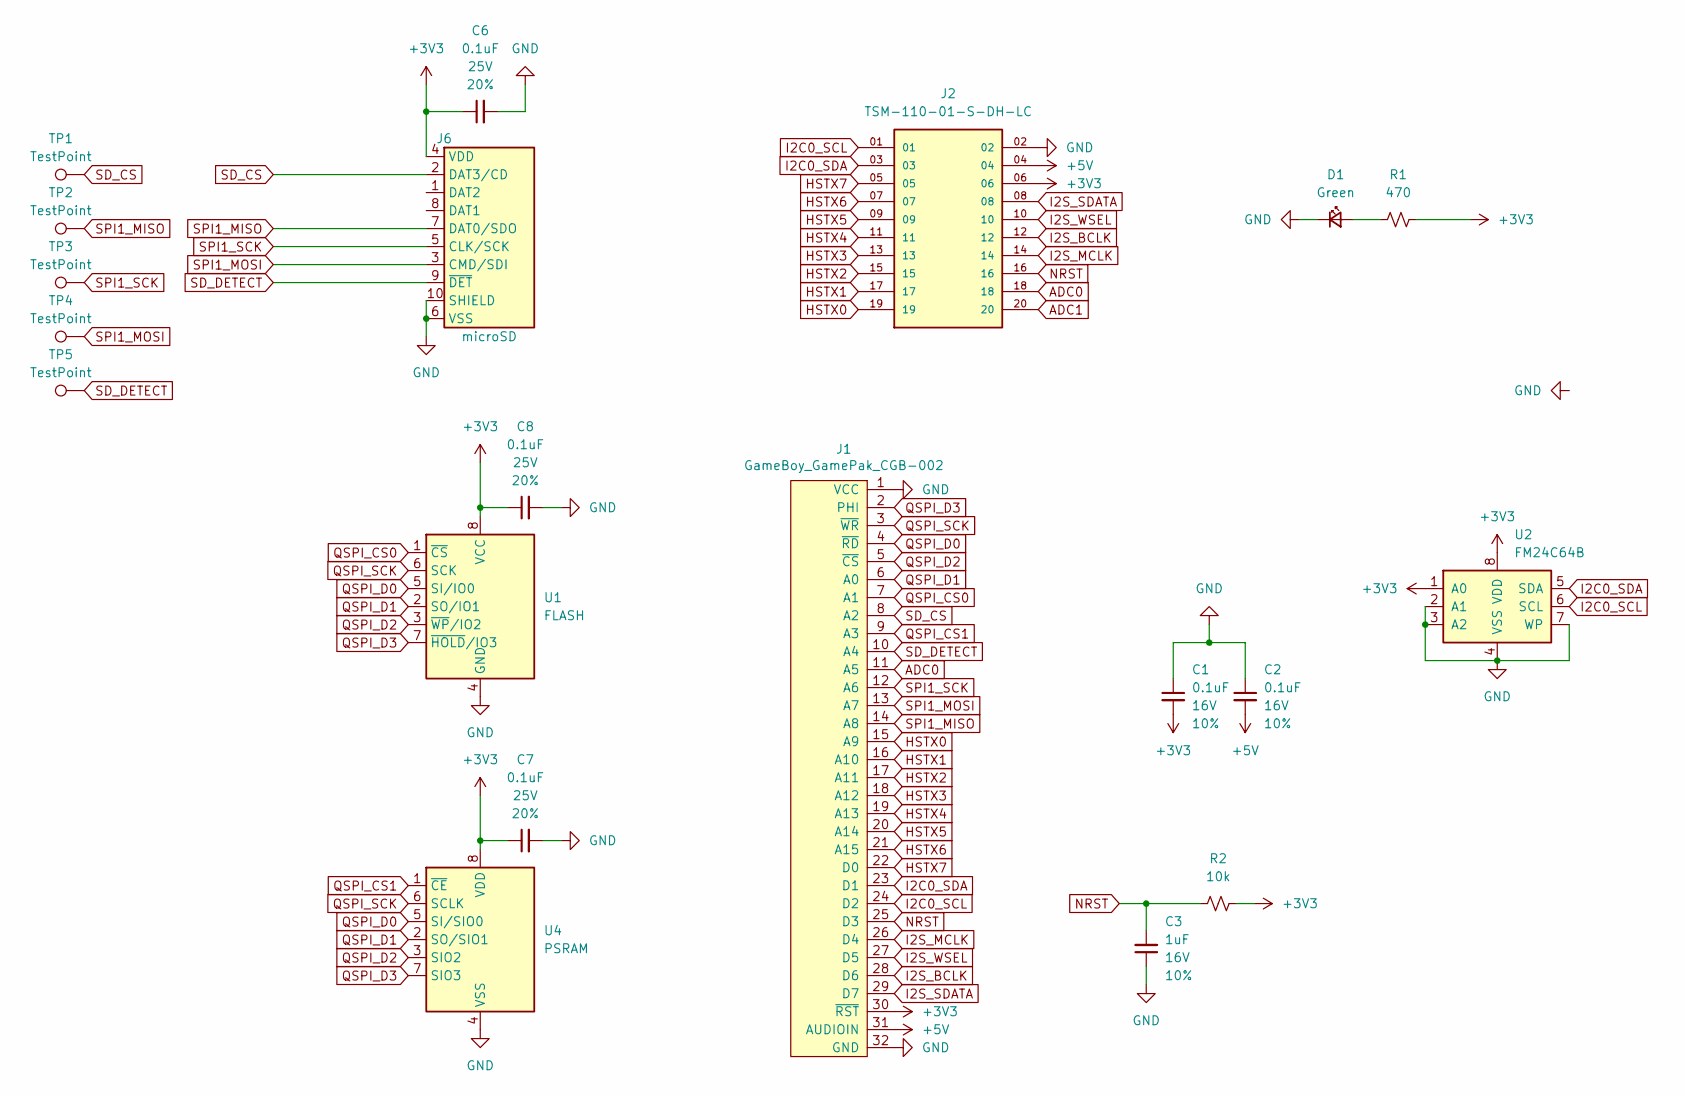
[picture p9: schematic stereoMag.kicad_sch]

Parts:
C1, C2: 0.1uF; C_1206_3216Metric; Voltage 16V; Tolerance 10%
C3: 1uF; C_0603_1608Metric; Voltage 16V; Tolerance 10%
C6, C7, C8: 0.1uF; C_0603_1608Metric; Voltage 25V; Tolerance 20%
D1: Green; LED_0603_1608Metric_Green
J1: GameBoy_GamePak_CGB-002; GameBoy_GamePak_CGB-002_P1.50mm_Edge
J2: TSM-110-01-S-DH-LC; SAMTEC_TSM-110-01-S-DH-LC; PARTREV R
J6: microSD; microSD_External_Pin
R1: 470; R_0603_1608Metric
R2: 10k; R_0603_1608Metric
TP1, TP2, TP3, TP4, TP5: TestPoint; TestPoint_Pad_D1.0mm
U1: FLASH; SOIC-8_3.9x4.9mm_P1.27mm
U2: FM24C64B; SOIC-8_3.9x4.9mm_P1.27mm
U4: PSRAM; SOIC-8_3.9x4.9mm_P1.27mm

Connections:
+3V3: C1.2, C6.1, C7.1, C8.1, J1.30 (~RST), J2.06, J6.4 (VDD), R1.2, R2.2, U1.8 (VCC), U2.1 (A0), U2.8 (VDD), U4.8 (VDD)
+5V: C2.2, J1.31 (AUDIOIN), J2.04
ADC0: J1.11 (A5), J2.18
ADC1: J2.20
GND: C1.1, C2.1, C3.1, C6.2, C7.2, C8.2, D1.1 (K), J1.1 (VCC), J1.32 (GND), J2.02, J6.6 (VSS), J6.10 (SHIELD), U1.4 (GND), U2.2 (A1), U2.3 (A2), U2.4 (VSS), U2.7 (WP), U4.4 (VSS)
HSTX0: J1.15 (A9), J2.19
HSTX1: J1.16 (A10), J2.17
HSTX2: J1.17 (A11), J2.15
HSTX3: J1.18 (A12), J2.13
HSTX4: J1.19 (A13), J2.11
HSTX5: J1.20 (A14), J2.09
HSTX6: J1.21 (A15), J2.07
HSTX7: J1.22 (D0), J2.05
I2C0_SCL: J1.24 (D2), J2.01, U2.6 (SCL)
I2C0_SDA: J1.23 (D1), J2.03, U2.5 (SDA)
I2S_BCLK: J1.28 (D6), J2.12
I2S_MCLK: J1.26 (D4), J2.14
I2S_SDATA: J1.29 (D7), J2.08
I2S_WSEL: J1.27 (D5), J2.10
NRST: C3.2, J1.25 (D3), J2.16, R2.1
unnamed: D1.2 (A), R1.1
QSPI_CS0: J1.7 (A1), U1.1 (~CS)
QSPI_CS1: J1.9 (A3), U4.1 (~CE)
QSPI_D0: J1.4 (~RD), U1.5 (SI/IO0), U4.5 (SI/SIO0)
QSPI_D1: J1.6 (A0), U1.2 (SO/IO1), U4.2 (SO/SIO1)
QSPI_D2: J1.5 (~CS), U1.3 (~WP/IO2), U4.3 (SIO2)
QSPI_D3: J1.2 (PHI), U1.7 (~HOLD/IO3), U4.7 (SIO3)
QSPI_SCK: J1.3 (~WR), U1.6 (SCK), U4.6 (SCLK)
SD_CS: J1.8 (A2), J6.2 (DAT3/CD), TP1.1
SD_DETECT: J1.10 (A4), J6.9 (~DET), TP5.1
SPI1_MISO: J1.14 (A8), J6.7 (DAT0/SDO), TP2.1
SPI1_MOSI: J1.13 (A7), J6.3 (CMD/SDI), TP4.1
SPI1_SCK: J1.12 (A6), J6.5 (CLK/SCK), TP3.1

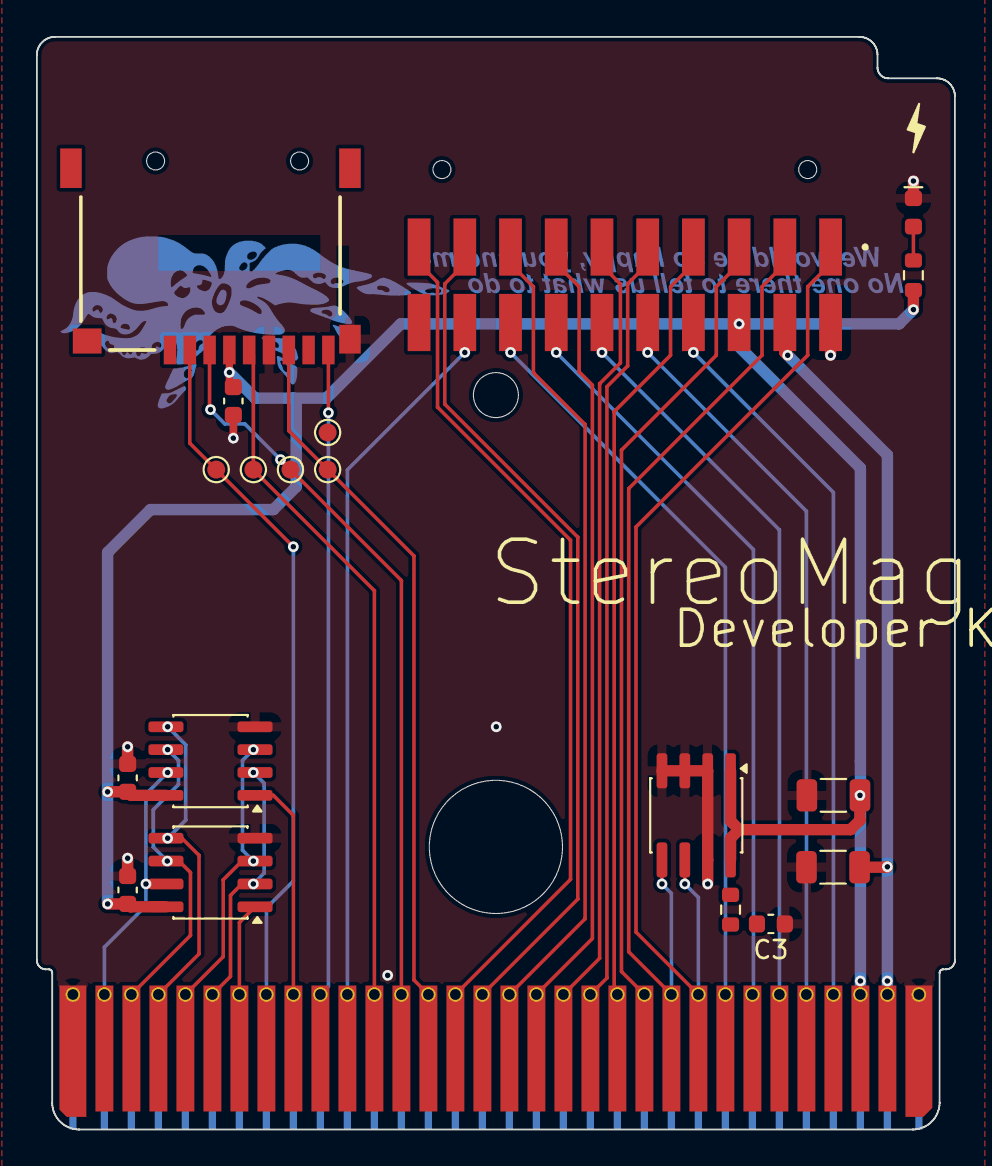
[picture p10: board stereoMag.kicad_pcb from above]

Board: 2 copper layers, 51.0 x 60.7 mm, 20 parts (0 on the bottom side), 32 nets.
