mikermak/StereoBoy_Firmware/retroid/kicad/hoofdprint/stereoBoy_MGB.kicad_pcb

## KiCad design retroid/kicad/hoofdprint/stereoBoy_MGB.kicad_pcb (2026-10-01)

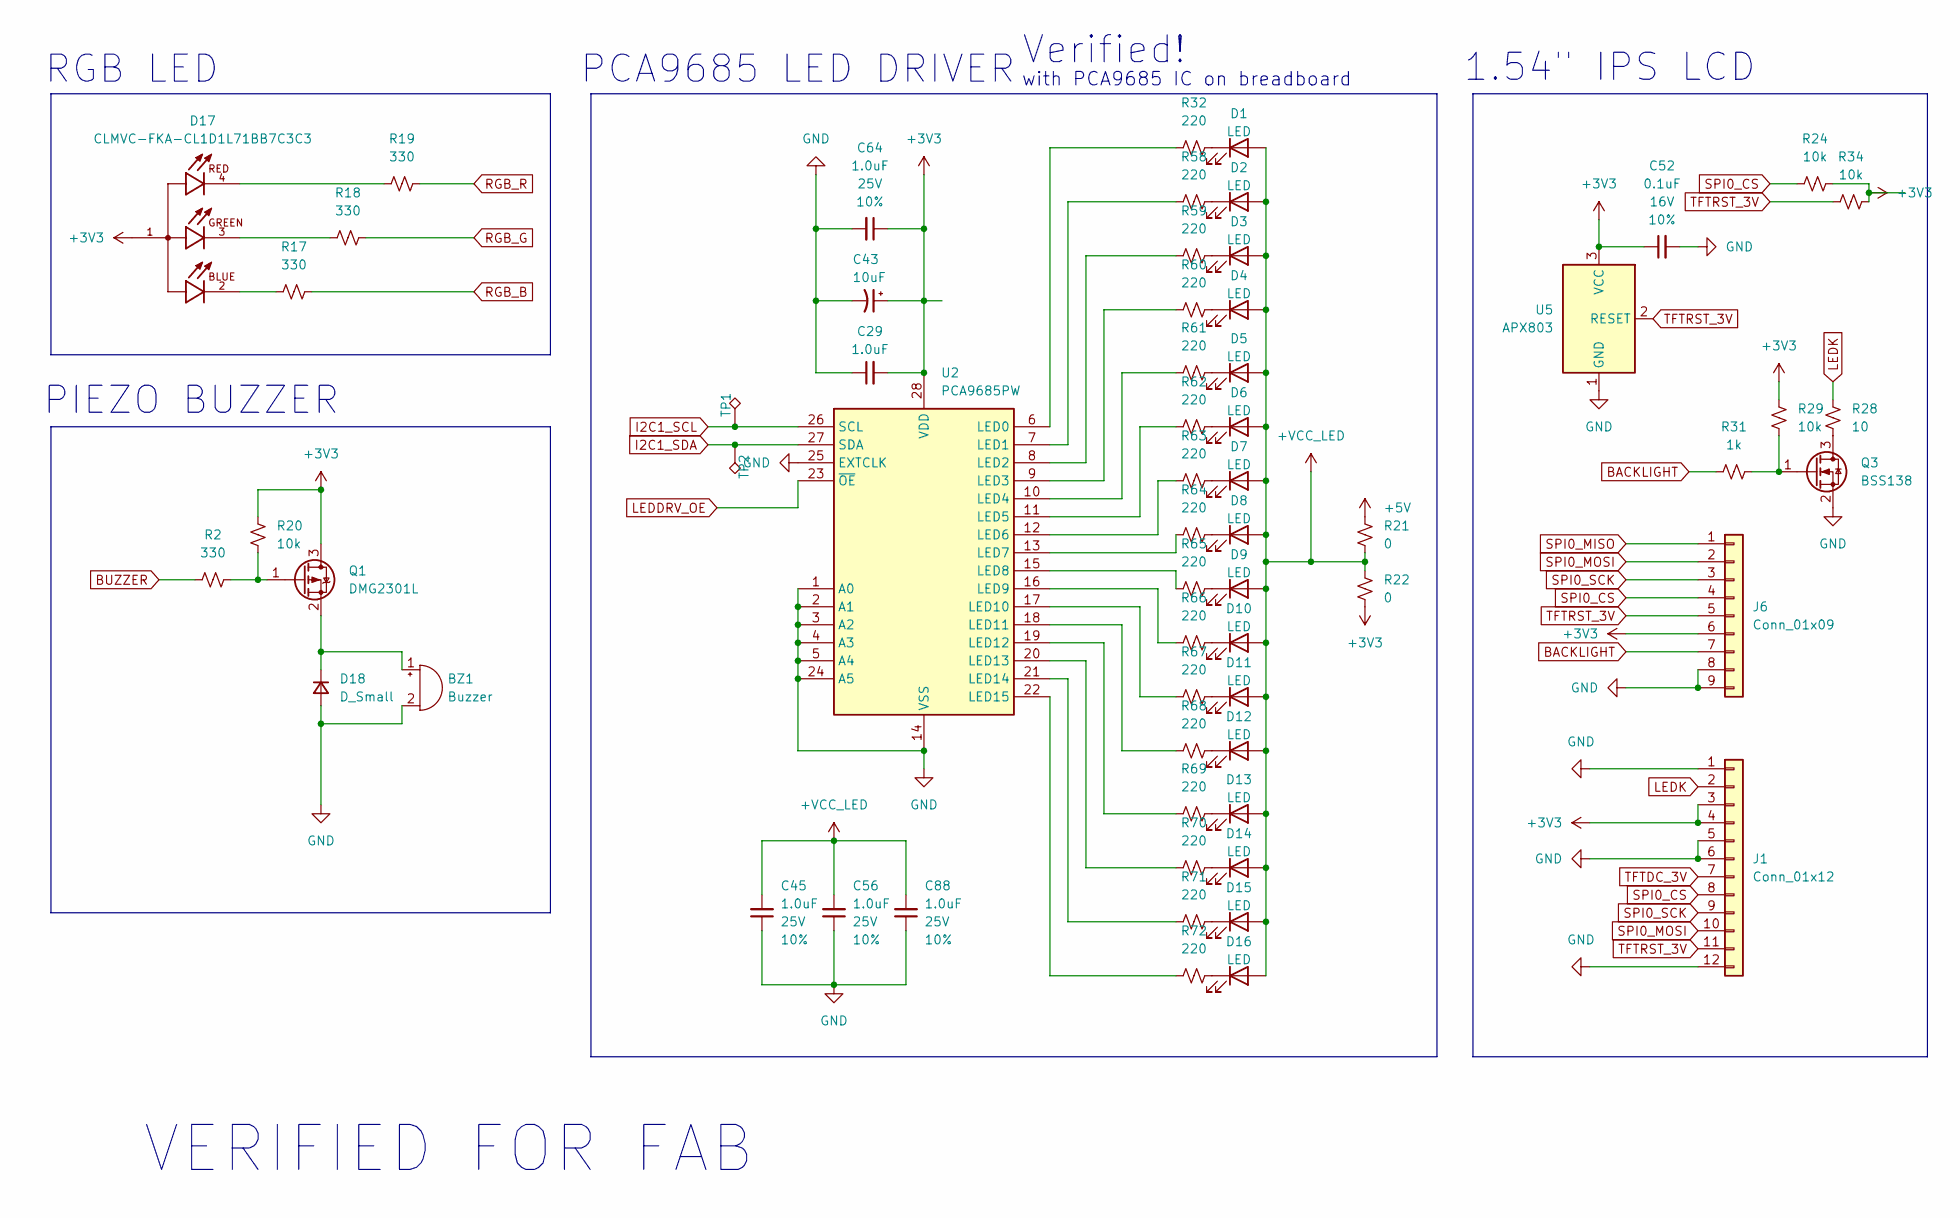
[picture p11: schematic stereoBoy_display.kicad_sch]

Parts:
BZ1: Buzzer; Buzzer_CUI_CPT-9019S-SMT
C29, C64: 1.0uF; C_0805_2012Metric; Voltage 25V; Tolerance 10%
C43: 10uF; CP_Elec_6.3x4.5; Voltage 6.3V; Tolerance 20%
C45, C56, C88: 1.0uF; C_1206_3216Metric; Voltage 25V; Tolerance 10%
C52: 0.1uF; C_0402_1005Metric; Voltage 16V; Tolerance 10%
D1, D2, D3, D4, D5, D6, D7, D8, D9, D10, D11, D12, D13, D14, D15, D16: LED; LED_D3.0mm
D17: CLMVC-FKA-CL1D1L71BB7C3C3; CREE_LED_2mm_x_2mm_Common_Anode; PARTREV 14
D18: D_Small; D_0603_1608Metric
J1: Conn_01x12; 1.54_IPS_FPC_Solder
J6: Conn_01x09; 1x09_P2.54mm
Q1: DMG2301L; SOT-23
Q3: BSS138; SOT-23
R2: 330; R_0603_1608Metric
R17, R18, R19: 330; R_0402_1005Metric
R20, R24, R29, R34: 10k; R_0603_1608Metric
R21, R22: 0; R_0603_1608Metric
R28: 10; R_0603_1608Metric
R31: 1k; R_0603_1608Metric
R32, R58, R59, R60, R61, R62, R63, R64, R65, R66, R67, R68, R69, R70, R71, R72: 220; R_0402_1005Metric
TP1, TP2: TestPoint_Alt; TestPoint_Pad_D1.0mm
U2: PCA9685PW; TSSOP-28_4.4x9.7mm_P0.65mm
U5: APX803; SOT-23

Connections:
+3V3: C29.2, C43.1, C52.1, C64.1, D17.1, J1.3, J1.4, J6.6, Q1.3 (D), R20.2, R22.1, R24.1, R29.2, R34.1, U2.28 (VDD), U5.3 (VCC); also elsewhere on the board
+5V: R21.2; also elsewhere on the board
+VCC_LED: C45.2, C56.2, C88.2, D1.2 (A), D2.2 (A), D3.2 (A), D4.2 (A), D5.2 (A), D6.2 (A), D7.2 (A), D8.2 (A), D9.2 (A), D10.2 (A), D11.2 (A), D12.2 (A), D13.2 (A), D14.2 (A), D15.2 (A), D16.2 (A), R21.1, R22.2
BACKLIGHT: J6.7, R31.2; also elsewhere on the board
BUZZER: R2.1; also elsewhere on the board
GND: BZ1.2 (-), C29.1, C43.2, C45.1, C52.2, C56.1, C64.2, C88.1, D18.2 (A), J1.1, J1.5, J1.6, J1.12, J6.8, J6.9, Q3.2 (S), U2.1 (A0), U2.2 (A1), U2.3 (A2), U2.4 (A3), U2.5 (A4), U2.14 (VSS), U2.24 (A5), U2.25 (EXTCLK), U5.1 (GND); also elsewhere on the board
I2C1_SCL: TP1.1, U2.26 (SCL); also elsewhere on the board
I2C1_SDA: TP2.1, U2.27 (SDA); also elsewhere on the board
LEDDRV_OE: U2.23 (~OE); also elsewhere on the board
LEDK: J1.2, R28.2
unnamed: BZ1.1 (+), D18.1 (K), Q1.2 (S)
unnamed: D1.1 (K), R32.2
unnamed: D2.1 (K), R58.2
unnamed: D3.1 (K), R59.2
unnamed: D4.1 (K), R60.2
unnamed: D5.1 (K), R61.2
unnamed: D6.1 (K), R62.2
unnamed: D7.1 (K), R63.2
unnamed: D8.1 (K), R64.2
unnamed: D9.1 (K), R65.2
unnamed: D10.1 (K), R66.2
unnamed: D11.1 (K), R67.2
unnamed: D12.1 (K), R68.2
unnamed: D13.1 (K), R69.2
unnamed: D14.1 (K), R70.2
unnamed: D15.1 (K), R71.2
unnamed: D16.1 (K), R72.2
unnamed: D17.2, R17.1
unnamed: D17.3, R18.1
unnamed: D17.4, R19.1
unnamed: Q1.1 (G), R2.2, R20.1
unnamed: Q3.3 (D), R28.1
unnamed: Q3.1 (G), R29.1, R31.1
unnamed: R32.1, U2.6 (LED0)
unnamed: R58.1, U2.7 (LED1)
unnamed: R59.1, U2.8 (LED2)
unnamed: R60.1, U2.9 (LED3)
unnamed: R61.1, U2.10 (LED4)
unnamed: R62.1, U2.11 (LED5)
unnamed: R63.1, U2.12 (LED6)
unnamed: R64.1, U2.13 (LED7)
unnamed: R65.1, U2.15 (LED8)
unnamed: R66.1, U2.16 (LED9)
unnamed: R67.1, U2.17 (LED10)
unnamed: R68.1, U2.18 (LED11)
unnamed: R69.1, U2.19 (LED12)
unnamed: R70.1, U2.20 (LED13)
unnamed: R71.1, U2.21 (LED14)
unnamed: R72.1, U2.22 (LED15)
RGB_B: R17.2; also elsewhere on the board
RGB_G: R18.2; also elsewhere on the board
RGB_R: R19.2; also elsewhere on the board
SPI0_CS: J1.8, J6.4, R24.2; also elsewhere on the board
SPI0_MISO: J6.1; also elsewhere on the board
SPI0_MOSI: J1.10, J6.2; also elsewhere on the board
SPI0_SCK: J1.9, J6.3; also elsewhere on the board
TFTDC_3V: J1.7; also elsewhere on the board
TFTRST_3V: J1.11, J6.5, R34.2, U5.2 (RESET); also elsewhere on the board

Notes on the sheet:
1.54" IPS LCD
with PCA9685 IC on breadboard
PIEZO BUZZER
RGB LED
Verified!
VERIFIED FOR FAB
PCA9685 LED DRIVER

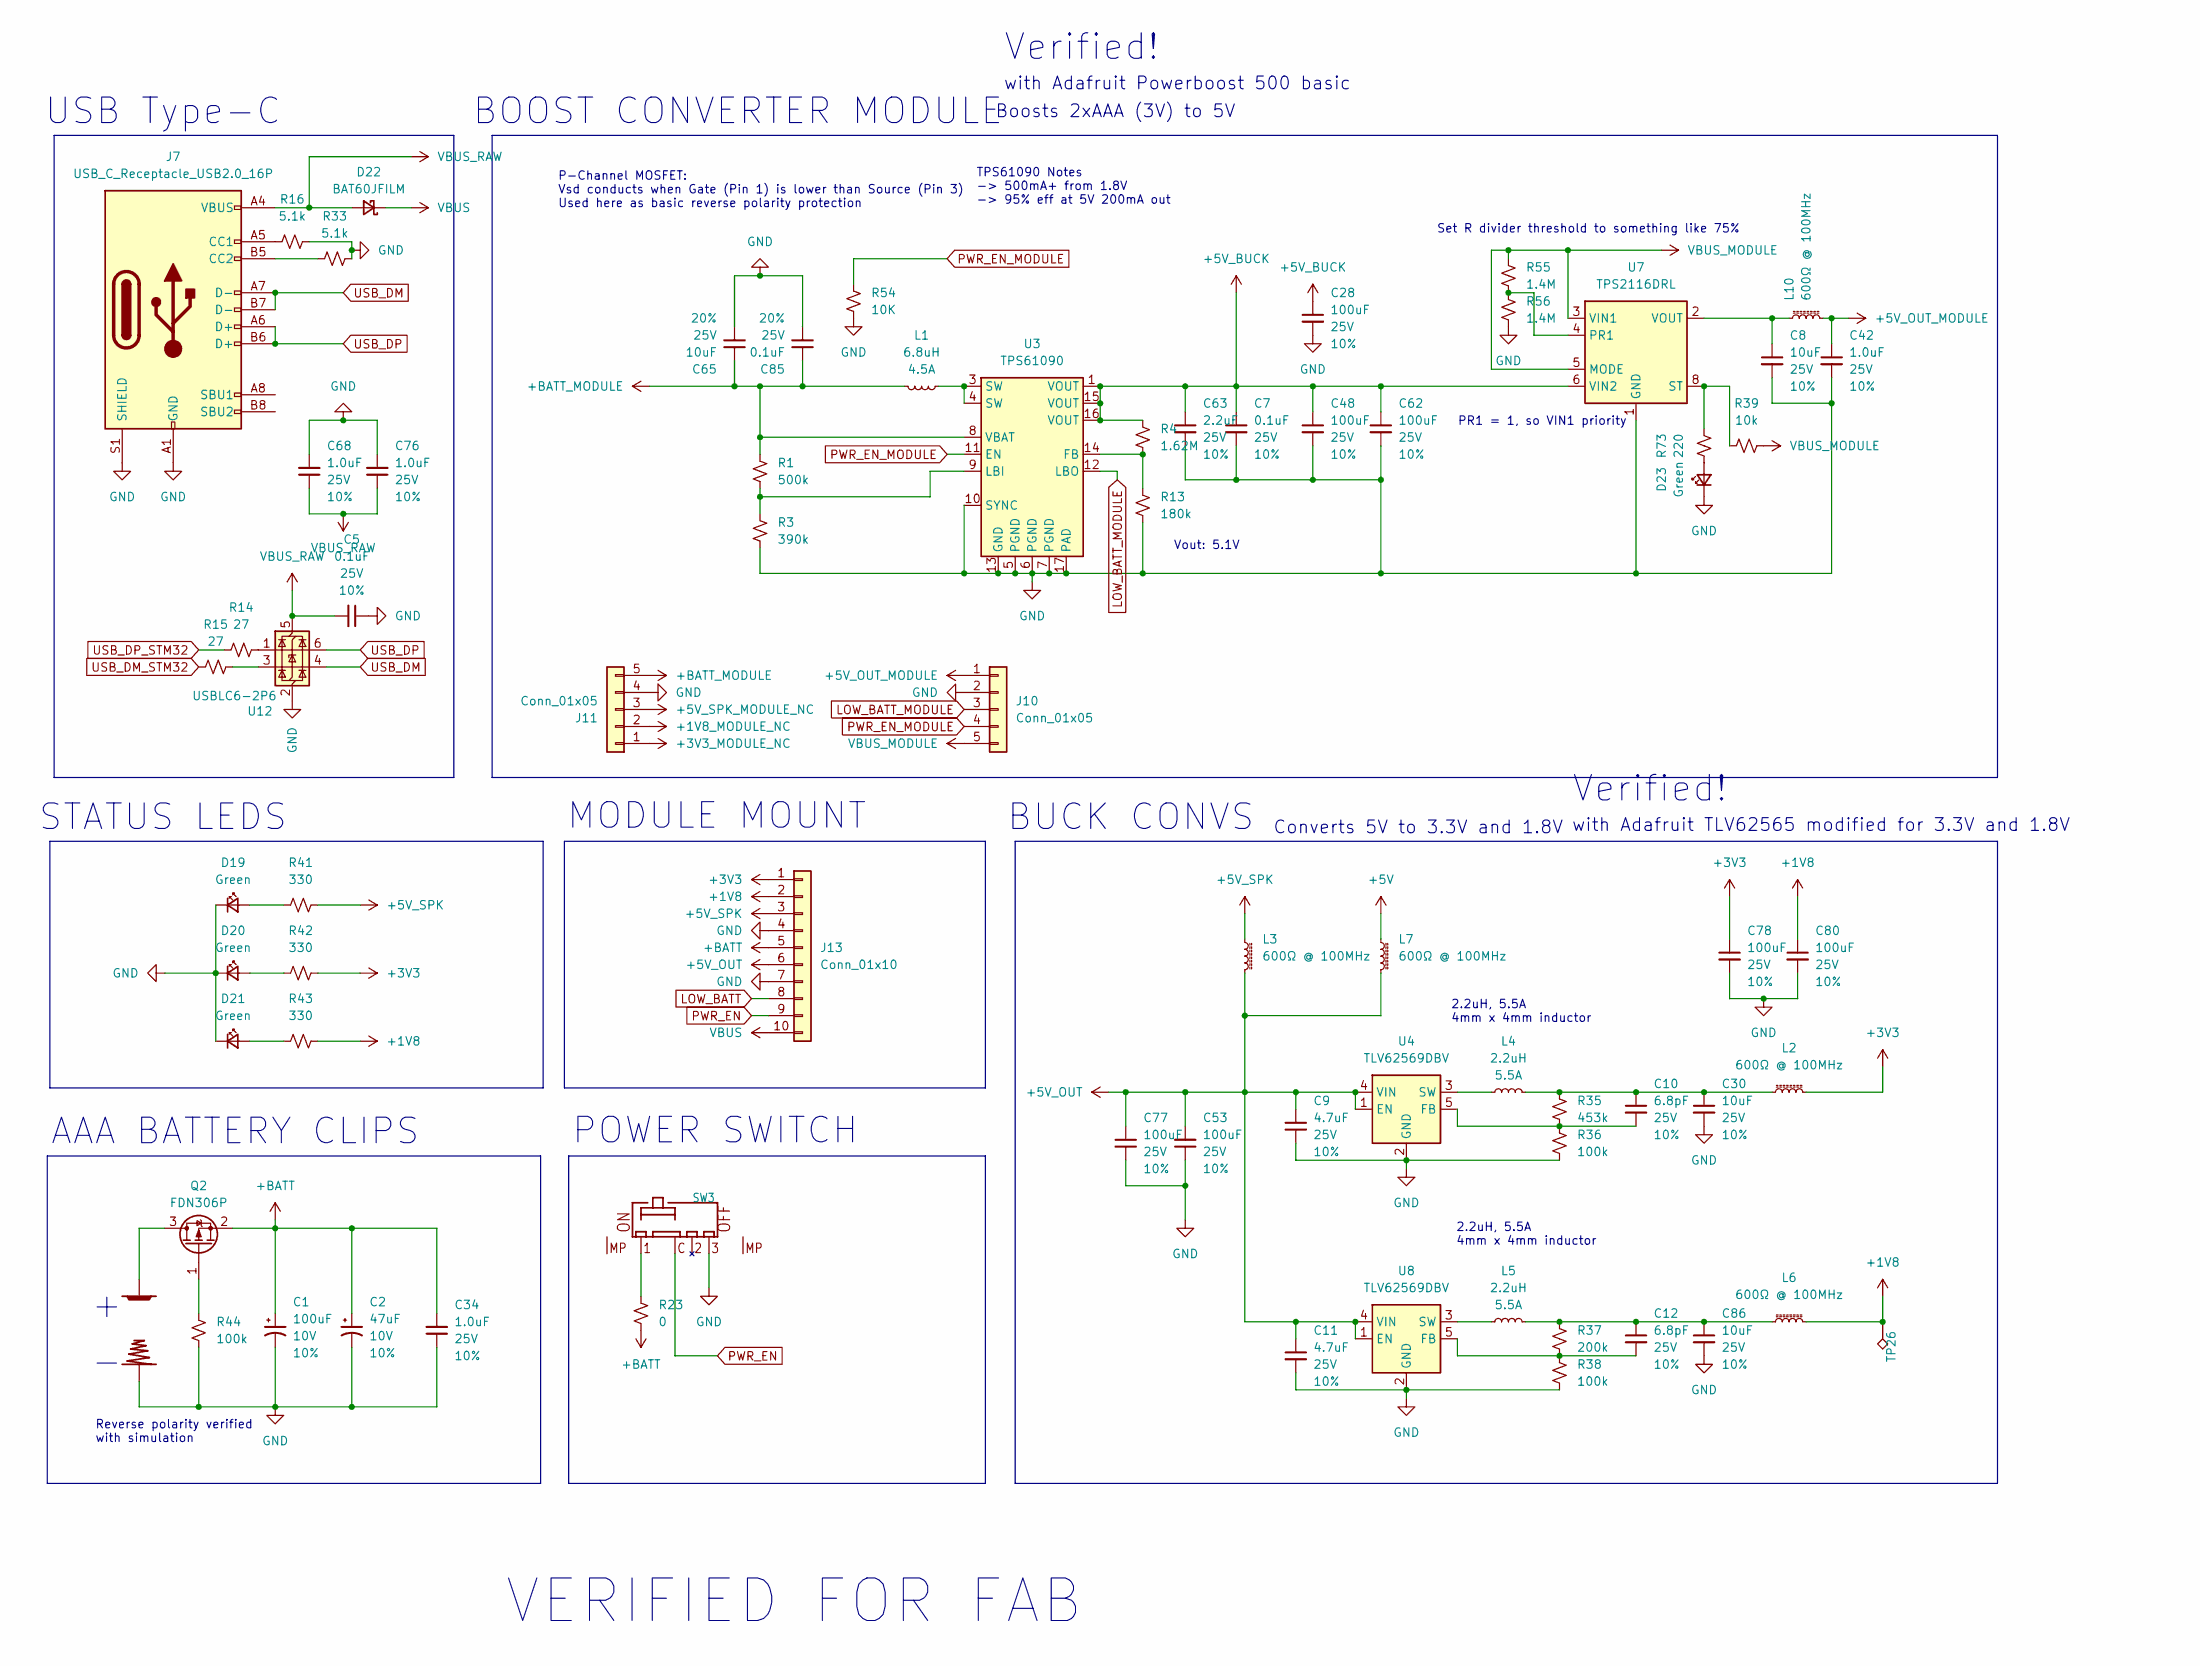
[picture p12: schematic stereoBoy_power.kicad_sch]

Parts:
+0: MGB+BATTERY4
-0: MGB-BATTERY4
C1: 100uF; CP_EIA-7343-15_Kemet-W_HandSolder; Voltage 10V; Tolerance 10%
C2: 47uF; CP_EIA-7343-15_Kemet-W_HandSolder; Voltage 10V; Tolerance 10%
C5: 0.1uF; C_0402_1005Metric; Voltage 25V; Tolerance 10%
C7: 0.1uF; C_0603_1608Metric; Voltage 25V; Tolerance 10%
C8: 10uF; C_1206_3216Metric; Voltage 25V; Tolerance 10%
C9, C11: 4.7uF; C_0805_2012Metric; Voltage 25V; Tolerance 10%
C10, C12: 6.8pF; C_0805_2012Metric; Voltage 25V; Tolerance 10%
C28: 100uF; C_0603_1608Metric; Voltage 25V; Tolerance 10%
C30, C86: 10uF; C_0805_2012Metric; Voltage 25V; Tolerance 10%
C34, C42: 1.0uF; C_1206_3216Metric; Voltage 25V; Tolerance 10%
C48, C53, C62, C77, C78, C80: 100uF; C_1206_3216Metric; Voltage 25V; Tolerance 10%
C63: 2.2uF; C_0603_1608Metric; Voltage 25V; Tolerance 10%
C65: 10uF; C_0603_1608Metric; Voltage 25V; Tolerance 20%
C68, C76: 1.0uF; C_0805_2012Metric; Voltage 25V; Tolerance 10%
C85: 0.1uF; C_0603_1608Metric; Voltage 25V; Tolerance 20%
D19, D20, D21: Green; LED_0603_1608Metric_Green
D22: BAT60JFILM; SOD-323
D23: Green; LED_1206_3216Metric_Green
J7: USB_C_Receptacle_USB2.0_16P; USB_C_Receptacle_GCT_USB4105-xx-A_16P_TopMnt_Horizontal
J10, J11: Conn_01x05; 1x05_P2.54mm
J13: Conn_01x10; StereoBoy_PSU
L1: 6.8uH; Inductor_7.3x6.6mm
L2, L6: 600Ω @ 100MHz; C_0603_1608Metric
L3, L7: 600Ω @ 100MHz; L_0603_1608Metric
L4, L5: 2.2uH; L_APV_ANR3012
L10: 600Ω @ 100MHz; L_0805_2012Metric
Q2: FDN306P; SOT-23
R1: 500k; R_0603_1608Metric
R3: 390k; R_0603_1608Metric
R4: 1.62M; C_0402_1005Metric
R13: 180k; C_0402_1005Metric
R14, R15: 27; C_0402_1005Metric
R16, R33: 5.1k; R_0603_1608Metric
R23: 0; R_0603_1608Metric
R35: 453k; R_0603_1608Metric
R36, R38: 100k; R_0603_1608Metric
R37: 200k; R_0603_1608Metric
R39: 10k; R_0603_1608Metric
R41, R42, R43: 330; R_0402_1005Metric
R44: 100k; R_0805_2012Metric
R54: 10K; R_0402_1005Metric
R55, R56: 1.4M; R_0603_1608Metric
R73: 220; R_0603_1608Metric
SW3: MGB-SW1; GBP_Power_Switch
TP26: TestPoint_Alt; TestPoint_Pad_D1.0mm
U3: TPS61090; Texas_RSA_VQFN-16-1EP_4x4mm_P0.65mm_EP2.7x2.7mm_ThermalVias
U4, U8: TLV62569DBV; SOT-23-5
U7: TPS2116DRL; SOT-583-8
U12: USBLC6-2P6; SOT-666

Connections:
+1V8: C80.1, J13.2, L6.2, R43.2, TP26.1; also elsewhere on the board
+1V8_MODULE_NC: J11.2
+3V3: C78.1, J13.1, L2.2, R42.2; also elsewhere on the board
+3V3_MODULE_NC: J11.1
+5V: L7.1; also elsewhere on the board
+5V_BUCK: C7.1, C28.1, C48.1, C62.1, C63.1, R4.1, U3.1 (VOUT), U3.15 (VOUT), U3.16 (VOUT), U7.6 (VIN2)
+5V_OUT: C9.1, C11.1, C53.2, C77.1, J13.6, L3.2, L7.2, U4.1 (EN), U4.4 (VIN), U8.1 (EN), U8.4 (VIN)
+5V_OUT_MODULE: C42.1, J10.1, L10.2
+5V_SPK: J13.3, L3.1, R41.2; also elsewhere on the board
+5V_SPK_MODULE_NC: J11.3
+BATT: C1.1, C2.1, C34.2, J13.5, Q2.2 (S), R23.1
+BATT_MODULE: C65.1, C85.1, J11.5, L1.2, R1.1, U3.8 (VBAT)
GND: -0.P$1, -0.P$3, -0.P$4, C1.2, C2.2, C5.1, C7.2, C8.2, C9.2, C11.2, C28.2, C30.2, C34.1, C42.2, C48.2, C53.1, C62.2, C63.2, C65.2, C68.2, C76.2, C77.2, C78.2, C80.2, C85.2, C86.2, D19.1 (K), D20.1 (K), D21.1 (K), D23.1 (K), J7.A1 (GND), J7.A12 (GND), J7.B1 (GND), J7.B12 (GND), J7.S1 (SHIELD), J10.2, J11.4, J13.4, J13.7, R3.2, R13.2, R16.2, R33.2, R36.2, R38.2, R44.1, R54.2, R56.2, SW3.P$3 (3), U3.5 (PGND), U3.6 (PGND), U3.7 (PGND), U3.10 (SYNC), U3.13 (GND), U3.17 (PAD), U4.2 (GND), U7.1 (GND), U8.2 (GND), U12.2 (GND); also elsewhere on the board
LOW_BATT: J13.8; also elsewhere on the board
LOW_BATT_MODULE: J10.3, U3.12 (LBO)
unnamed: C8.1, L10.1, U7.2 (VOUT), U7.7 (VOUT)
unnamed: C10.1, C30.1, L2.1, L4.2, R35.1
unnamed: C12.1, C86.1, L5.2, L6.1, R37.1
unnamed: D19.2 (A), R41.1
unnamed: D20.2 (A), R42.1
unnamed: D21.2 (A), R43.1
unnamed: D23.2 (A), R73.1
unnamed: J7.A5 (CC1), R16.1
unnamed: J7.B5 (CC2), R33.1
unnamed: L1.1, U3.3 (SW), U3.4 (SW)
unnamed: +0.P$1, +0.P$2, +0.P$3, Q2.3 (D)
unnamed: Q2.1 (G), R44.2
unnamed: R14.2, U12.1 (I/O1)
unnamed: R15.2, U12.3 (I/O2)
unnamed: R23.2, SW3.P$1 (1)
unnamed: R4.2, R13.1, U3.14 (FB)
unnamed: R1.2, R3.1, U3.9 (LBI)
unnamed: C10.2, R35.2, R36.1, U4.5 (FB)
unnamed: L4.1, U4.3 (SW)
unnamed: R55.2, R56.1, U7.4 (PR1)
unnamed: R39.1, R73.2, U7.8 (ST)
unnamed: C12.2, R37.2, R38.1, U8.5 (FB)
unnamed: L5.1, U8.3 (SW)
PWR_EN: J13.9, SW3.P$C (C)
PWR_EN_MODULE: J10.4, R54.1, U3.11 (EN)
USB_DM: J7.A7 (D-), J7.B7 (D-), U12.4 (I/O2)
USB_DM_STM32: R15.1; also elsewhere on the board
USB_DP: J7.A6 (D+), J7.B6 (D+), U12.6 (I/O1)
USB_DP_STM32: R14.1; also elsewhere on the board
VBUS: D22.1 (K), J13.10
VBUS_MODULE: J10.5, R39.2, R55.1, U7.3 (VIN1), U7.5 (MODE)
VBUS_RAW: C5.2, C68.1, C76.1, D22.2 (A), J7.A4 (VBUS), J7.A9 (VBUS), J7.B4 (VBUS), J7.B9 (VBUS), U12.5 (VBUS)

Notes on the sheet:
with Adafruit Powerboost 500 basic
Vout: 5.1V
AAA BATTERY CLIPS
2.2uH, 5.5A 4mm x 4mm inductor
MODULE MOUNT
BUCK CONVS
STATUS LEDS
with Adafruit TLV62565 modified for 3.3V and 1.8V
Converts 5V to 3.3V and 1.8V
PR1 = 1, so VIN1 priority
POWER SWITCH
Reverse polarity verified with simulation
Boosts 2xAAA (3V) to 5V
Set R divider threshold to something like 75%
P-Channel MOSFET: Vsd conducts when Gate (Pin 1) is lower than Source (Pin 3) Used here as basic reverse polarity protection
USB Type-C
BOOST CONVERTER MODULE
VERIFIED FOR FAB
Verified!
TPS61090 Notes -> 500mA+ from 1.8V -> 95% eff at 5V 200mA out

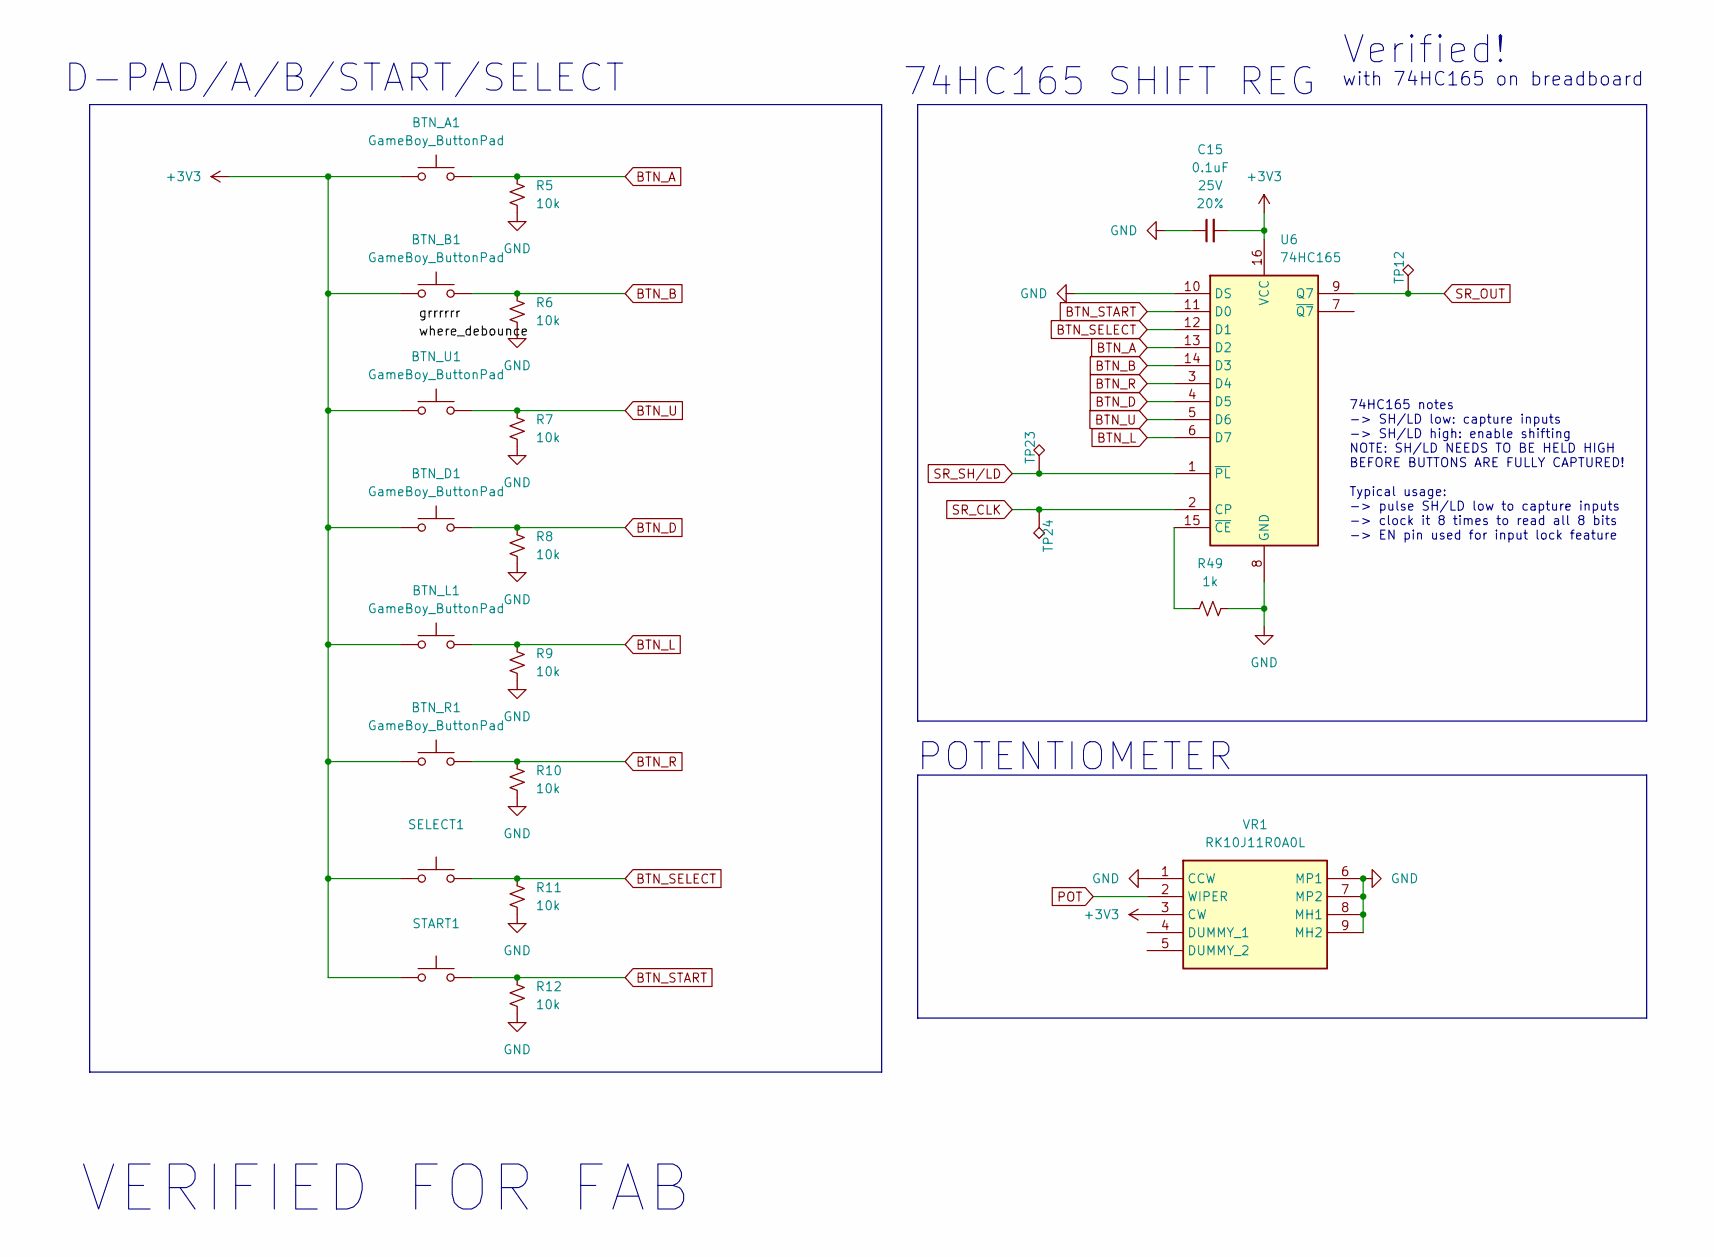
[picture p13: schematic stereoBoy_input.kicad_sch]

Parts:
BTN_A1: GameBoy_ButtonPad; GameBoy_A_B_Pad
BTN_B1: GameBoy_ButtonPad; GameBoy_A_B_Pad
BTN_D1: GameBoy_ButtonPad; GameBoy_DPad
BTN_L1: GameBoy_ButtonPad; GameBoy_DPad
BTN_R1: GameBoy_ButtonPad; GameBoy_DPad
BTN_U1: GameBoy_ButtonPad; GameBoy_DPad
C15: 0.1uF; C_0402_1005Metric; Voltage 25V; Tolerance 20%
R5, R6, R7, R8, R9, R10, R11, R12: 10k; R_0603_1608Metric
R49: 1k; R_0402_1005Metric
SELECT1: SMD_6x3.5mm_h2.5mm; GameBoy_Select_Start; Mfg Part# 8-004 SMD Button 8x3.6mm Height=2.5mm
START1: SMD_6x3.5mm_h2.5mm; GameBoy_Select_Start; Mfg Part# 8-004 SMD Button 8x3.6mm Height=2.5mm
TP12, TP23, TP24: TestPoint_Alt; TestPoint_Pad_D1.0mm
U6: 74HC165; TSSOP-16_4.4x5mm_P0.65mm
VR1: RK10J11R0A0L; Manufacturer_Part_Number RK10J11R0A0L; Mouser Part Number 688-RK10J11R0A0L

Connections:
+3V3: BTN_A1.1, BTN_B1.1, BTN_D1.1, BTN_L1.1, BTN_R1.1, BTN_U1.1, C15.2, SELECT1.1, START1.1, U6.16 (VCC), VR1.3 (CW); also elsewhere on the board
BTN_A: BTN_A1.2, R5.2, U6.13 (D2)
BTN_B: BTN_B1.2, R6.2, U6.14 (D3)
BTN_D: BTN_D1.2, R8.2, U6.4 (D5)
BTN_L: BTN_L1.2, R9.2, U6.6 (D7)
BTN_R: BTN_R1.2, R10.2, U6.3 (D4)
BTN_SELECT: R11.2, SELECT1.2, U6.12 (D1)
BTN_START: R12.2, START1.2, U6.11 (D0)
BTN_U: BTN_U1.2, R7.2, U6.5 (D6)
GND: C15.1, R5.1, R6.1, R7.1, R8.1, R9.1, R10.1, R11.1, R12.1, R49.2, U6.8 (GND), U6.10 (DS), VR1.1 (CCW), VR1.6 (MP1), VR1.7 (MP2), VR1.8 (MH1), VR1.9 (MH2); also elsewhere on the board
unnamed: R49.1, U6.15 (~CE)
POT: VR1.2 (WIPER); also elsewhere on the board
SR_CLK: TP24.1, U6.2 (CP); also elsewhere on the board
SR_OUT: TP12.1, U6.9 (Q7); also elsewhere on the board
SR_SH/LD: TP23.1, U6.1 (~PL); also elsewhere on the board

Notes on the sheet:
74HC165 SHIFT REG
Verified!
D-PAD/A/B/START/SELECT
VERIFIED FOR FAB
74HC165 notes -> SH/LD low: capture inputs -> SH/LD high: enable shifting NOTE: SH/LD NEEDS TO BE HELD HIGH BEFORE BUTTONS ARE FULLY CAPTURED! Typical usage: -> pulse SH/LD low to capture inputs -> clock it 8 times to read all 8 bits -> EN pin used for input lock feature
with 74HC165 on breadboard
POTENTIOMETER
