mikermak/StereoBoy_Firmware/retroid/kicad/hoofdprint/stereoBoy_MGB.kicad_pcb

## KiCad design retroid/kicad/hoofdprint/stereoBoy_MGB.kicad_pcb (continued)

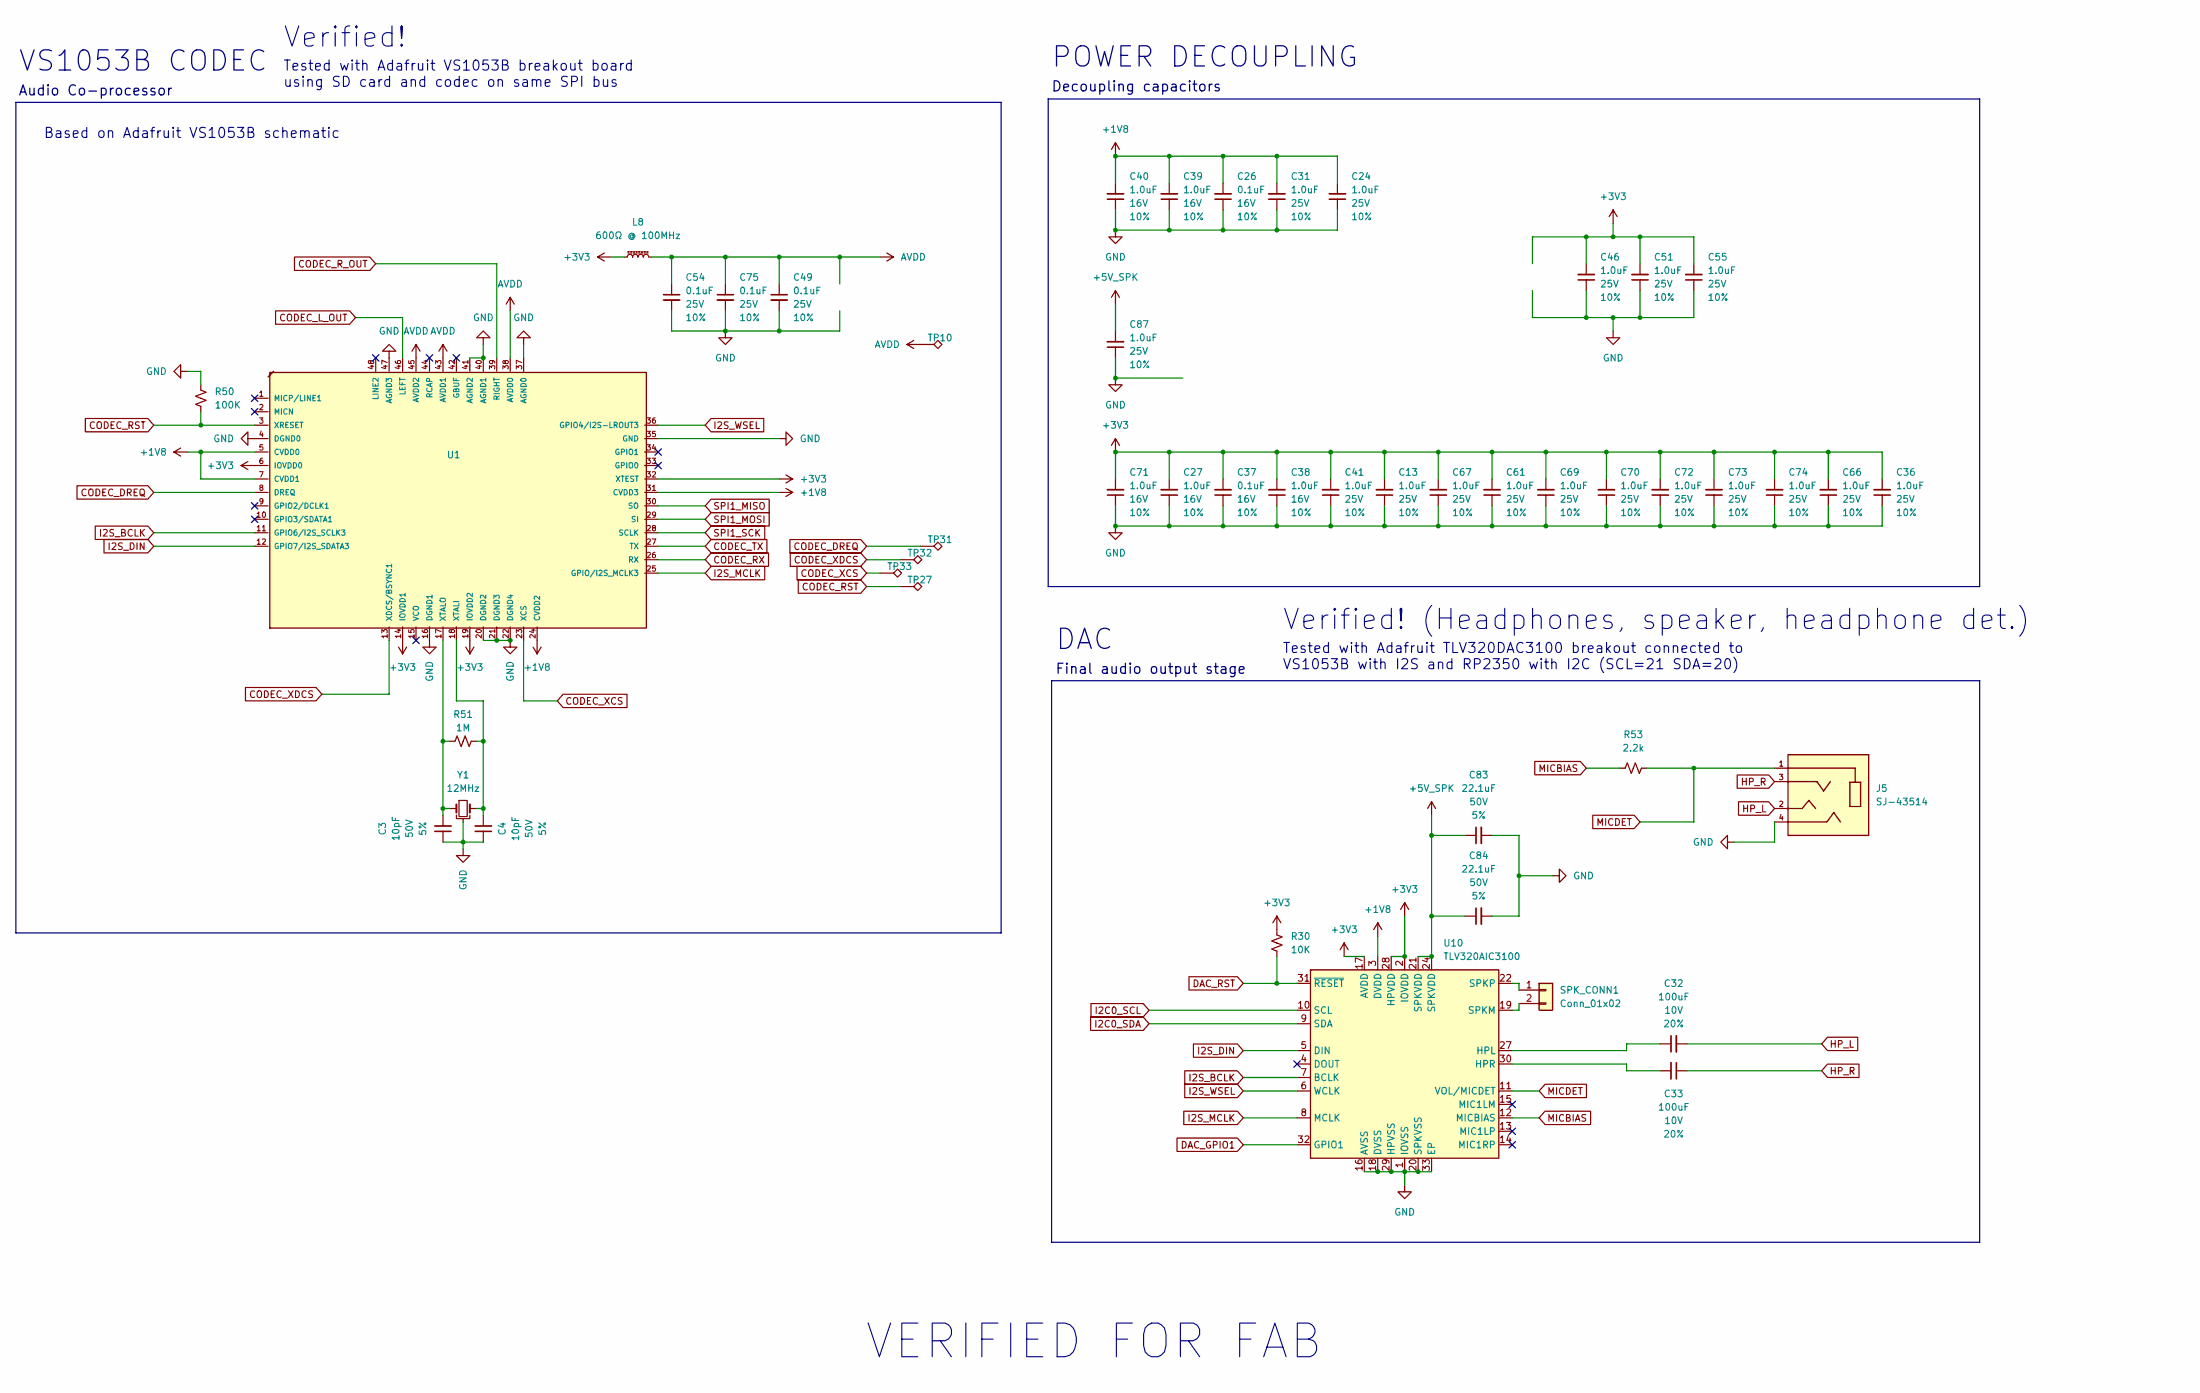
[picture p14: schematic stereoBoy_audio.kicad_sch]

Parts:
C3, C4: 10pF; C_0402_1005Metric; Voltage 50V; Tolerance 5%
C13, C24, C31, C36, C41: 1.0uF; C_0402_1005Metric; Voltage 25V; Tolerance 10%
C26, C37: 0.1uF; C_0402_1005Metric; Voltage 16V; Tolerance 10%
C27, C38, C39, C40, C71: 1.0uF; C_0402_1005Metric; Voltage 16V; Tolerance 10%
C32, C33: 100uF; C_1206_3216Metric; Voltage 10V; Tolerance 20%
C46, C51, C55, C66, C67, C70, C72, C73, C74: 1.0uF; C_1206_3216Metric; Voltage 25V; Tolerance 10%
C49, C75: 0.1uF; C_0402_1005Metric; Voltage 25V; Tolerance 10%
C54: 0.1uF; C_0603_1608Metric; Voltage 25V; Tolerance 10%
C61, C69, C87: 1.0uF; C_0805_2012Metric; Voltage 25V; Tolerance 10%
C83, C84: 22.1uF; C_0402_1005Metric; Voltage 50V; Tolerance 5%
J5: SJ-43514; SJ_43514; PART_REV 1.04
L8: 600Ω @ 100MHz; C_0603_1608Metric
R30: 10K; R_0402_1005Metric
R50: 100K; R_0402_1005Metric
R51: 1M; R_0402_1005Metric
R53: 2.2k; R_0402_1005Metric
SPK_CONN1: Conn_01x02; 1x02
TP10, TP27, TP31, TP32, TP33: TestPoint_Alt; TestPoint_Pad_D1.0mm
U1: VS1053B-lqfp48; VS1053b; MPN VS1053B
U10: TLV320AIC3100; VQFN-32-1EP_5x5mm_P0.5mm_EP3.5x3.5mm
Y1: 12MHz; Crystal_SMD_3225-4Pin_3.2x2.5mm

Connections:
+1V8: C24.2, C26.2, C31.2, C39.2, C40.2, U1.5 (CVDD0), U1.7 (CVDD1), U1.24 (CVDD2), U1.31 (CVDD3), U10.3 (DVDD); also elsewhere on the board
+3V3: C13.2, C27.2, C36.2, C37.2, C38.2, C41.2, C46.2, C51.2, C55.2, C61.2, C66.2, C67.2, C69.2, C70.2, C71.2, C72.2, C73.2, C74.2, L8.1, R30.2, U1.6 (IOVDD0), U1.14 (IOVDD1), U1.19 (IOVDD2), U1.32 (XTEST), U10.2 (IOVDD), U10.17 (AVDD), U10.28 (HPVDD); also elsewhere on the board
+5V_SPK: C83.1, C84.1, C87.2, U10.21 (SPKVDD), U10.24 (SPKVDD); also elsewhere on the board
AVDD: C49.1, C54.1, C75.1, L8.2, TP10.1, U1.38 (AVDD0), U1.43 (AVDD1), U1.45 (AVDD2)
CODEC_DREQ: TP31.1, U1.8 (DREQ); also elsewhere on the board
CODEC_L_OUT: U1.46 (LEFT); also elsewhere on the board
CODEC_RST: R50.1, TP27.1, U1.3 (XRESET); also elsewhere on the board
CODEC_RX: U1.26 (RX)
CODEC_R_OUT: U1.39 (RIGHT); also elsewhere on the board
CODEC_TX: U1.27 (TX)
CODEC_XCS: TP33.1, U1.23 (XCS); also elsewhere on the board
CODEC_XDCS: TP32.1, U1.13 (XDCS/BSYNC1); also elsewhere on the board
DAC_GPIO1: U10.32 (GPIO1); also elsewhere on the board
DAC_RST: R30.1, U10.31 (~RESET); also elsewhere on the board
GND: C3.1, C4.1, C13.1, C24.1, C26.1, C27.1, C31.1, C36.1, C37.1, C38.1, C39.1, C40.1, C41.1, C46.1, C49.2, C51.1, C54.2, C55.1, C61.1, C66.1, C67.1, C69.1, C70.1, C71.1, C72.1, C73.1, C74.1, C75.2, C83.2, C84.2, C87.1, J5.4, R50.2, U1.4 (DGND0), U1.16 (DGND1), U1.20 (DGND2), U1.21 (DGND3), U1.22 (DGND4), U1.35 (GND), U1.37 (AGND0), U1.40 (AGND1), U1.41 (AGND2), U1.47 (AGND3), U10.1 (IOVSS), U10.16 (AVSS), U10.18 (DVSS), U10.20 (SPKVSS), U10.25 (SPKVSS), U10.29 (HPVSS), U10.33 (EP), Y1.2, Y1.4; also elsewhere on the board
HP_L: C32.2, J5.2
HP_R: C33.1, J5.3
I2C0_SCL: U10.10 (SCL); also elsewhere on the board
I2C0_SDA: U10.9 (SDA); also elsewhere on the board
I2S_BCLK: U1.11 (GPIO6/I2S_SCLK3), U10.7 (BCLK); also elsewhere on the board
I2S_DIN: U1.12 (GPIO7/I2S_SDATA3), U10.5 (DIN); also elsewhere on the board
I2S_MCLK: U1.25 (GPIO/I2S_MCLK3), U10.8 (MCLK); also elsewhere on the board
I2S_WSEL: U1.36 (GPIO4/I2S-LROUT3), U10.6 (WCLK); also elsewhere on the board
MICBIAS: R53.2, U10.12 (MICBIAS)
MICDET: J5.1, R53.1, U10.11 (VOL/MICDET)
unnamed: SPK_CONN1.1, U10.22 (SPKP), U10.26 (SPKP)
unnamed: SPK_CONN1.2, U10.19 (SPKM), U10.23 (SPKM)
unnamed: C4.2, R51.1, U1.18 (XTALI), Y1.3
unnamed: C3.2, R51.2, U1.17 (XTALO), Y1.1
unnamed: C32.1, U10.27 (HPL)
unnamed: C33.2, U10.30 (HPR)
SPI1_MISO: U1.30 (SO); also elsewhere on the board
SPI1_MOSI: U1.29 (SI); also elsewhere on the board
SPI1_SCK: U1.28 (SCLK); also elsewhere on the board

Notes on the sheet:
DAC
VERIFIED FOR FAB
POWER DECOUPLING
Tested with Adafruit TLV320DAC3100 breakout connected to VS1053B with I2S and RP2350 with I2C (SCL=21 SDA=20)
Verified!
Tested with Adafruit VS1053B breakout board using SD card and codec on same SPI bus
Based on Adafruit VS1053B schematic
Decoupling capacitors
Audio Co-processor
VS1053B CODEC
Final audio output stage
Verified! (Headphones, speaker, headphone det.)

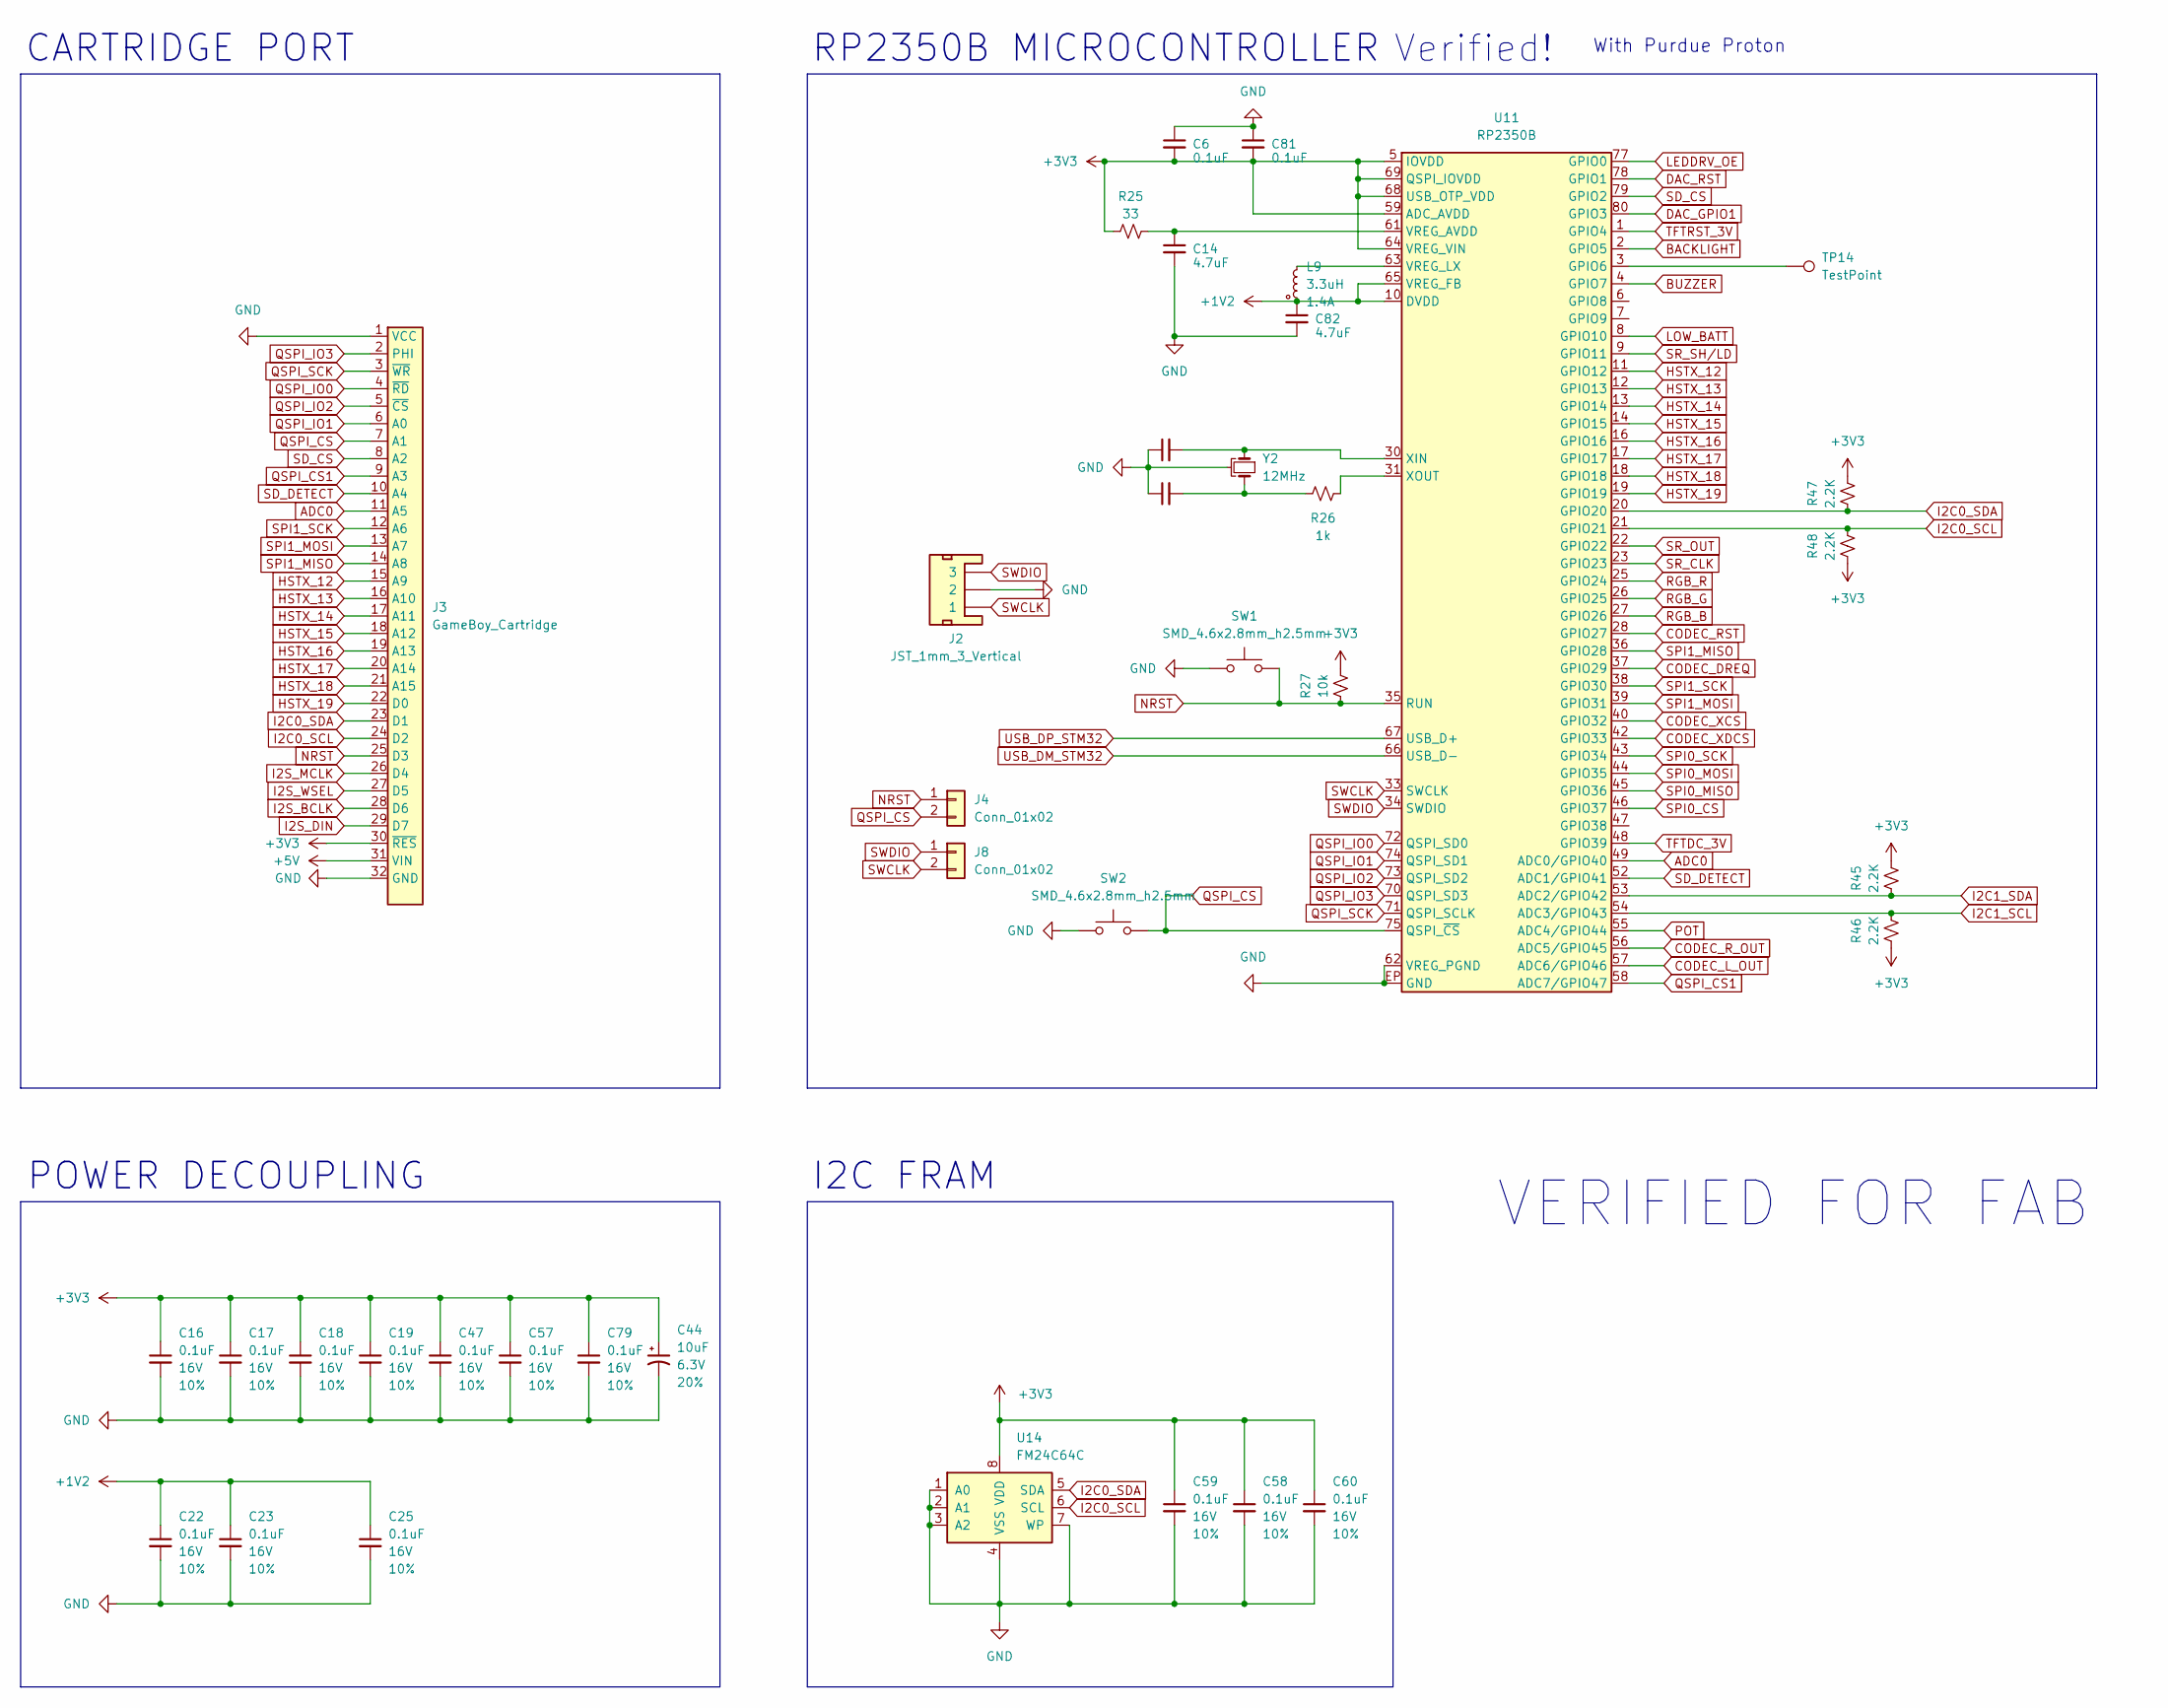
[picture p15: schematic stereoBoy_cpu.kicad_sch]

Parts:
C6: 0.1uF; C_0402_1005Metric
C14: 4.7uF; C_0402_1005Metric
C16, C17, C18, C19, C22, C23, C25, C47, C57, C58, C60, C79: 0.1uF; C_0402_1005Metric; Voltage 16V; Tolerance 10%
C20, C21: 15pF; C_0402_1005Metric; Voltage 50V; Tolerance 5%
C44: 10uF; CP_Elec_6.3x4.5; Voltage 6.3V; Tolerance 20%
C59: 0.1uF; C_0805_2012Metric; Voltage 16V; Tolerance 10%
C81: 0.1uF; WAi_0402_1005Metric
C82: 4.7uF; WAi_0402_1005Metric
J2: JST_1mm_3_Vertical; JST_1x03_P1.0mm_Horizontal_SMD
J3: GameBoy_Cartridge; MGB-CART-CONN
J4, J8: Conn_01x02; 1x02_P2.54mm
L9: 3.3uH; L_Cenker_CKCS201610
R25: 33; R_0402_1005Metric
R26: 1k; R_0402_1005Metric
R27: 10k; R_0603_1608Metric
R45, R46, R47, R48: 2.2K; R_0402_1005Metric
SW1, SW2: SMD_4.6x2.8mm_h2.5mm; Push_SMD_4.6x2.8mm_h2.5mm
TP14: TestPoint; TestPoint_Pad_D1.0mm
U11: RP2350B; QFN-80-1EP_10x10mm_P0.4mm_EP3.4x3.4mm
U14: FM24C64C; SOIC-8_3.9x4.9mm_P1.27mm
Y2: 12MHz; Crystal_SMD_3225-4Pin_3.2x2.5mm

Connections:
+1V2: C22.1, C23.1, C25.1, C82.1, L9.1, U11.10 (DVDD), U11.32 (DVDD), U11.51 (DVDD), U11.65 (VREG_FB)
+3V3: C6.2, C16.1, C17.1, C18.1, C19.1, C44.1, C47.1, C57.1, C58.1, C59.1, C60.1, C79.1, C81.2, J3.30 (~RES), R25.1, R27.2, R45.2, R46.1, R47.2, R48.1, U11.5 (IOVDD), U11.15 (IOVDD), U11.24 (IOVDD), U11.29 (IOVDD), U11.41 (IOVDD), U11.50 (IOVDD), U11.59 (ADC_AVDD), U11.60 (IOVDD), U11.64 (VREG_VIN), U11.68 (USB_OTP_VDD), U11.69 (QSPI_IOVDD), U11.76 (IOVDD), U14.8 (VDD); also elsewhere on the board
+5V: J3.31 (VIN); also elsewhere on the board
ADC0: J3.11 (A5), U11.49 (ADC0/GPIO40)
BACKLIGHT: U11.2 (GPIO5); also elsewhere on the board
BUZZER: U11.4 (GPIO7); also elsewhere on the board
CODEC_DREQ: U11.37 (GPIO29); also elsewhere on the board
CODEC_L_OUT: U11.57 (ADC6/GPIO46); also elsewhere on the board
CODEC_RST: U11.28 (GPIO27); also elsewhere on the board
CODEC_R_OUT: U11.56 (ADC5/GPIO45); also elsewhere on the board
CODEC_XCS: U11.40 (GPIO32); also elsewhere on the board
CODEC_XDCS: U11.42 (GPIO33); also elsewhere on the board
DAC_GPIO1: U11.80 (GPIO3); also elsewhere on the board
DAC_RST: U11.78 (GPIO1); also elsewhere on the board
GND: C6.1, C14.2, C16.2, C17.2, C18.2, C19.2, C20.1, C21.1, C22.2, C23.2, C25.2, C44.2, C47.2, C57.2, C58.2, C59.2, C60.2, C79.2, C81.1, C82.2, J2.2, J3.1 (VCC), J3.32 (GND), SW1.1, SW2.1, U11.62 (VREG_PGND), U11.EP (GND), U14.1 (A0), U14.2 (A1), U14.3 (A2), U14.4 (VSS), U14.7 (WP), Y2.2, Y2.4; also elsewhere on the board
HSTX_12: J3.15 (A9), U11.11 (GPIO12)
HSTX_13: J3.16 (A10), U11.12 (GPIO13)
HSTX_14: J3.17 (A11), U11.13 (GPIO14)
HSTX_15: J3.18 (A12), U11.14 (GPIO15)
HSTX_16: J3.19 (A13), U11.16 (GPIO16)
HSTX_17: J3.20 (A14), U11.17 (GPIO17)
HSTX_18: J3.21 (A15), U11.18 (GPIO18)
HSTX_19: J3.22 (D0), U11.19 (GPIO19)
I2C0_SCL: J3.24 (D2), R48.2, U11.21 (GPIO21), U14.6 (SCL); also elsewhere on the board
I2C0_SDA: J3.23 (D1), R47.1, U11.20 (GPIO20), U14.5 (SDA); also elsewhere on the board
I2C1_SCL: R46.2, U11.54 (ADC3/GPIO43); also elsewhere on the board
I2C1_SDA: R45.1, U11.53 (ADC2/GPIO42); also elsewhere on the board
I2S_BCLK: J3.28 (D6); also elsewhere on the board
I2S_DIN: J3.29 (D7); also elsewhere on the board
I2S_MCLK: J3.26 (D4); also elsewhere on the board
I2S_WSEL: J3.27 (D5); also elsewhere on the board
LEDDRV_OE: U11.77 (GPIO0); also elsewhere on the board
LOW_BATT: U11.8 (GPIO10); also elsewhere on the board
NRST: J3.25 (D3), J4.1, R27.1, SW1.2, U11.35 (RUN)
unnamed: C21.2, R26.1, Y2.3
unnamed: TP14.1, U11.3 (GPIO6)
unnamed: C14.1, R25.2, U11.61 (VREG_AVDD)
unnamed: L9.2, U11.63 (VREG_LX)
unnamed: C20.2, U11.30 (XIN), Y2.1
unnamed: R26.2, U11.31 (XOUT)
POT: U11.55 (ADC4/GPIO44); also elsewhere on the board
QSPI_CS: J3.7 (A1), J4.2, SW2.2, U11.75 (QSPI_~CS)
QSPI_CS1: J3.9 (A3), U11.58 (ADC7/GPIO47)
QSPI_IO0: J3.4 (~RD), U11.72 (QSPI_SD0)
QSPI_IO1: J3.6 (A0), U11.74 (QSPI_SD1)
QSPI_IO2: J3.5 (~CS), U11.73 (QSPI_SD2)
QSPI_IO3: J3.2 (PHI), U11.70 (QSPI_SD3)
QSPI_SCK: J3.3 (~WR), U11.71 (QSPI_SCLK)
RGB_B: U11.27 (GPIO26); also elsewhere on the board
RGB_G: U11.26 (GPIO25); also elsewhere on the board
RGB_R: U11.25 (GPIO24); also elsewhere on the board
SD_CS: J3.8 (A2), U11.79 (GPIO2)
SD_DETECT: J3.10 (A4), U11.52 (ADC1/GPIO41)
SPI0_CS: U11.46 (GPIO37); also elsewhere on the board
SPI0_MISO: U11.45 (GPIO36); also elsewhere on the board
SPI0_MOSI: U11.44 (GPIO35); also elsewhere on the board
SPI0_SCK: U11.43 (GPIO34); also elsewhere on the board
SPI1_MISO: J3.14 (A8), U11.36 (GPIO28); also elsewhere on the board
SPI1_MOSI: J3.13 (A7), U11.39 (GPIO31); also elsewhere on the board
SPI1_SCK: J3.12 (A6), U11.38 (GPIO30); also elsewhere on the board
SR_CLK: U11.23 (GPIO23); also elsewhere on the board
SR_OUT: U11.22 (GPIO22); also elsewhere on the board
SR_SH/LD: U11.9 (GPIO11); also elsewhere on the board
SWCLK: J2.1, J8.2, U11.33 (SWCLK)
SWDIO: J2.3, J8.1, U11.34 (SWDIO)
TFTDC_3V: U11.48 (GPIO39); also elsewhere on the board
TFTRST_3V: U11.1 (GPIO4); also elsewhere on the board
USB_DM_STM32: U11.66 (USB_D-); also elsewhere on the board
USB_DP_STM32: U11.67 (USB_D+); also elsewhere on the board

Notes on the sheet:
VERIFIED FOR FAB
With Purdue Proton
I2C FRAM
POWER DECOUPLING
Verified!
CARTRIDGE PORT
RP2350B MICROCONTROLLER

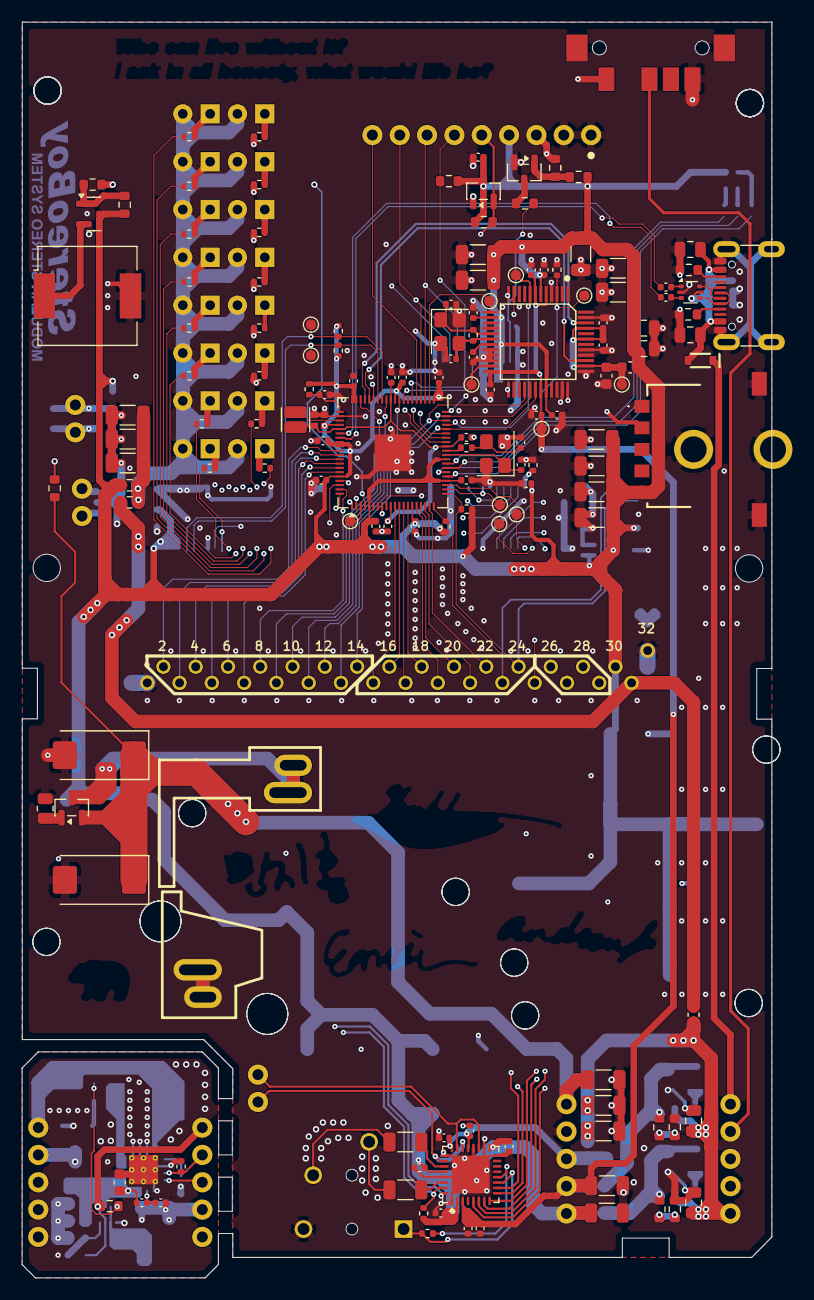
[picture p16: board stereoBoy_MGB.kicad_pcb from above]

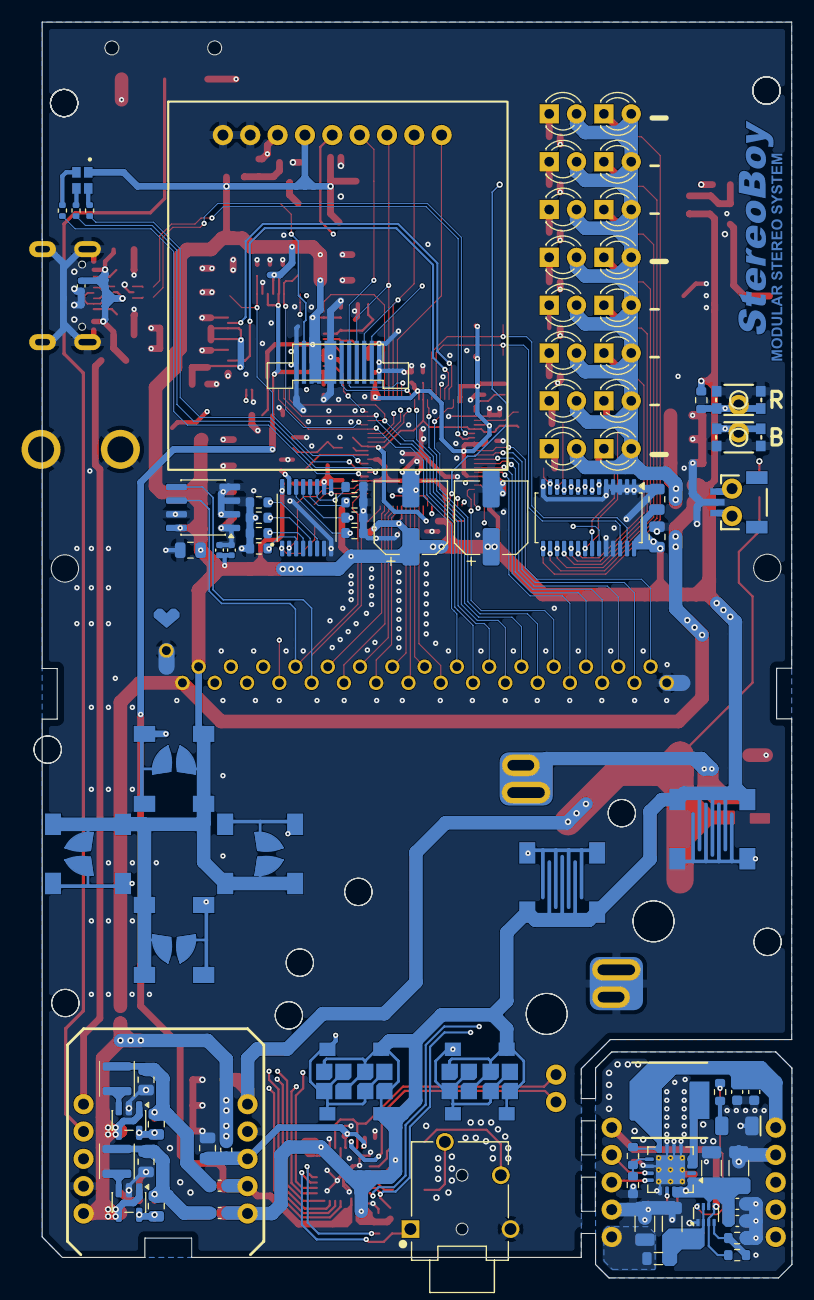
[picture p17: board stereoBoy_MGB.kicad_pcb from below]

Board: 4 copper layers, 69.7 x 116.7 mm, 249 parts (84 on the bottom side), 165 nets.

Other parts of the board:
UNK_HOLE_0: dummyfp0
UNK_HOLE_1: dummyfp1
UNK_HOLE_4: dummyfp4
UNK_HOLE_5: dummyfp5
UNK_HOLE_6: dummyfp6
UNK_HOLE_7: dummyfp7
UNK_HOLE_8: dummyfp8
UNK_HOLE_9: dummyfp9
UNK_HOLE_10: dummyfp10
UNK_HOLE_11: dummyfp11
UNK_HOLE_12: dummyfp12
