mikermak/StereoBoy_Firmware/(commit log)

2026-10-01 Read the cartridge SD card over SPI1 by default, keep SDIO as a build option
    The StereoMag dev kit cartridge wires the microSD socket to SPI1 (shared
    with the VS1053) with CS on GPIO 2, so the SDIO setup on GPIO 12-17 never
    finds the card. SDIO stays available with -DSB_SD_SDIO=ON.
2026-10-01 Add Retroid build: branded colour-silkscreen board and JLCPCB production files
    Production-ready set under retroid/: KiCad 10 main board with the drill/place
    origin at the bottom-left corner, Gerbers merged with EasyEDA multi-colour
    silkscreen files, JLCPCB BOM/CPL with verified LCSC parts, the StereoMag
    cartridge, the artwork and the scripts that generate it, a prebuilt UF2 and
    a Dutch ordering checklist. Electrically unchanged (DRC: 0 unconnected,
    0 schematic-parity issues).
    [JLCPCB_BOM.csv, StereoBoy_bestellijst.xlsx, omtrek_cartridge.dxf, omtrek_hoofdprint.dxf, positions_kicad.csv, stereoBoy_MGB.kicad_pcb, stereoBoy_MGB.kicad_sch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]
